8BitMixtape/ABK-20/.agents/skills/antigravity/SKILL.md

---
name: Antigravity Codebase Management
description: Comprehensive framework for generating 8-bit audio/visual synthesizers, managing the TinyAudioBoot WAV pipeline, and creating animated 5x4 matrix GIF & audio previews on ATtiny85 hardware.
---

# 8Bit-Vintage & Antigravity ATtiny85 Architecture & Workflows

This skill provides essential domain knowledge, architectural patterns, and standard workflows for creating, testing, and deploying audio synthesizers for the **8Bit Mixtape** and **ABK-20** (ATtiny85).

---

## 🛑 MANDATORY: Two-Phase Sound Development Workflow

When creating new sounds or synthesizers for the **ABK-20** or **8Bit Mixtape**, always strictly adhere to this two-phase process:

```
  PHASE 1: Local Code & Hardware Testing
  ┌────────────────────────────────────────────────────────┐
  │ 1. Write/edit C++ code in src/<app_id>.cpp             │
  │ 2. Activate in platformio.ini                          │
  │ 3. Run "pio run" (verify flash <= 6300 bytes)          │
  │ 4. User uploads & tests physically on hardware         │
  │ 5. Iterate on sound, controls & visuals                │
  │                                                        │
  │ ⛔ DO NOT create GIFs, MP3s, manuals, or apps.json!    │
  └────────────────────────────────────────────────────────┘
                            │
               User says: "Finalize this sound"
                            ▼
  PHASE 2: Web Assets & Publishing (ON USER COMMAND ONLY)
  ┌────────────────────────────────────────────────────────┐
  │ 1. Generate matrix GIF: scripts/gen_previews.py        │
  │ 2. Write manual: web/manuals/<APP_ID>_MANUAL.md        │
  │ 3. Generate preview MP3: scripts/gen_audio_previews.py │
  │ 4. Copy WAV: cp firmware.wav web/wav/<app_id>.wav      │
  │ 5. Register in web/apps.json & sync web/apps.js        │
  │ 6. Commit & push to GitHub                             │
  └────────────────────────────────────────────────────────┘
```

### Phase 1: Local Development & Hardware Testing (Iterative Loop)
1. **Develop Code Locally**:
   - Write or update `src/<app_id>.cpp`.
   - Use `my_delay()` (never Arduino's standard `delay()` which hangs when Timer0 is hijacked).
   - Ensure flash size $\le 6,300$ bytes (TinyAudioBoot ceiling).
   - Keep RAM $\le 80$ bytes (out of 512B).
2. **Compile Firmware**:
   - Select sketch in `platformio.ini` (`build_src_filter = -<*>, +<<app_id>.cpp>`).
   - Run compilation: `pio run`. PlatformIO compiles and generates `.pio/build/attiny85/firmware.hex` and `.pio/build/attiny85/firmware.wav`.
3. **Hardware Upload & Testing (User-Driven)**:
   - Instruct the user to upload: `pio run --target upload` (or play `.pio/build/attiny85/firmware.wav` into the audio jack).
   - The user tests the sound, potentiometers, buttons, and NeoPixel clarity on physical hardware.
   - Refine and iterate code based on user feedback.
4. **STRICT RULE DURING PHASE 1**:
   - **DO NOT** generate GIFs.
   - **DO NOT** generate MP3 audio previews.
   - **DO NOT** write manuals.
   - **DO NOT** modify `web/apps.json`, `web/apps.js`, or `web/index.html`.
   - Keep the workspace focused purely on getting the code and hardware sound perfect first!

### Phase 2: Web Assets & Finalization (ONLY ON EXPLICIT USER COMMAND)
Only when the user is completely satisfied with the sound and explicitly commands to publish/finalize:
1. **Create Preview GIF**:
   - Implement `<app_id>_frames()` in `scripts/gen_previews.py`.
   - Run: `python3 scripts/gen_previews.py <app_id>`.
2. **Write User Manual**:
   - Create `web/manuals/<APP_ID_UPPER>_MANUAL.md`.
3. **Generate Audio Preview MP3**:
   - Implement `synth_<app_id>()` in `scripts/gen_audio_previews.py`.
   - Run: `python3 -c "from scripts.gen_audio_previews import ...; write_wav_to_mp3(s, r, 'web/audio/<app_id>.mp3')"`.
4. **Publish Production WAV**:
   - Copy `.pio/build/attiny85/firmware.wav` to `web/wav/<app_id>.wav`.
5. **Update Web Catalog**:
   - Add entry to `web/apps.json` with final `flash_bytes` and `wav_bytes`.
   - Sync `web/apps.js` and verify `web/index.html`.
6. **Commit & Push**:
   - Git stage, commit, and push to GitHub.

---

## 1. Hardware Specifications & Pin Mapping

* **MCU**: Microchip ATtiny85 (8 KB Flash, 512 B SRAM, 512 B EEPROM)
* **Clock**: 16 MHz Internal PLL (required for WS2812B 800 kHz bit-bang timing)
* **Audio DAC**: 8-bit PWM carrier running at ~250 kHz generated by Timer1 in 64 MHz PLL mode on PB1 (`OC1A`)
* **Audio Sequencer/Sample Clock**: Timer0 COMPA interrupt running at 10 kHz (100 µs tick)
* **Visuals**: 20x WS2812B / SK6812 NeoPixels arranged in a 5×4 matrix on PB0
* **Inputs**:
  * PB4 (ADC2 / A2): Left Potentiometer (`POTI_LEFT`)
  * PB2 (ADC1 / A1): Right Potentiometer (`POTI_RIGHT`)
  * PB3 (ADC3 / A3): Resistor Ladder Pushbuttons (`BUTTON_PIN`)
  * PB5: Reset Pin (Power-On reset used by AudioBoot)

### Resistor Ladder Button Calibration (PB3 / A3)
```cpp
#define Vbutton_releaseLevel  490
#define Vbutton_left          460
#define Vbutton_right         395
#define Vbutton_both          320
```

> [!CAUTION]
> **Timer0 & Delay Rule**: When Timer0 is configured for a custom 10 kHz sample clock (`TCCR0A = 3; TCCR0B = 0x0A; OCR0A = 199;`), the Arduino core `delay()` and `micros()` will hang because `TOV0` (overflow) never triggers. Always use the tick-based delay routine:
> ```cpp
> void my_delay(uint16_t ms) {
>   uint16_t duration = ms * 10;
>   uint16_t start;
>   uint8_t sreg = SREG; cli(); start = ticks; SREG = sreg;
>   while (1) {
>     uint16_t current;
>     sreg = SREG; cli(); current = ticks; SREG = sreg;
>     if ((uint16_t)(current - start) >= duration) break;
>   }
> }
> ```

---

## 2. Animated Matrix GIF Previews (`scripts/gen_previews.py`)

*(Executed only in Phase 2 upon user command).*

### Matrix Geometry & Canvas
* **Matrix Size**: 5 columns wide $\times$ 4 rows high (20 LEDs total).
* **Cell Size**: Each virtual LED is rendered as a $30\text{ px} \times 24\text{ px}$ cell with a $1\text{ px}$ dark border (`(10, 10, 10)`), producing an overall GIF dimension of **$150\text{ px} \times 96\text{ px}$**.
* **Engine**: Python Pillow (`PIL.Image`).

### Adding a New GIF Preview
1. In `scripts/gen_previews.py`, define `<app_id>_frames()` returning `(frames_list, delay_ms)` (typically 30–60 frames @ 50 ms = 20 FPS).
2. Register: `RENDERERS["<app_id>"] = <app_id>_frames`.
3. Ensure app is registered in `web/apps.json`.
4. Run: `python3 scripts/gen_previews.py <app_id>`. Output: `web/gifs/<app_id>.gif`.

---

## 3. The Vintage "Analog Noise" Texture Technique

When designing visualizer frames for retro synthesizers (like *Léon Theremin*, *Bach Air*, or *Schaltkreiskontrolle*), you can intentionally harness Pillow's 8-bit palette quantizer to produce an authentic **vacuum-tube / cathode-ray glow & radio-static dithering**:

* **How it Works**:
  Instead of rendering only binary, flat on/off RGB blocks, incorporate continuous mathematical gradients:
  * Soft sinusoids: `int((math.sin(x * 0.8 + y * 0.9 + f * 0.2) * 0.5 + 0.5) * 35)`
  * Multi-stop phosphor persistence: trace = `(40, 255, 60)`, adjacent persistence halo = `(10, 80, 20)`
  * Candle flame / plasma flicker: `(f * 7) & 31`
* **Result**:
  When Pillow quantizes these continuous RGB values into an indexed 256-color GIF palette, **Floyd-Steinberg error-diffusion dithering** scatters intermediate shades across adjacent matrix cells. This generates a subtle, living analogue "grain" reminiscent of 1920s electron tubes and CRT scopes!

---

## 4. Audio Preview Generation (`scripts/gen_audio_previews.py`)

*(Executed only in Phase 2 upon user command).*

1. **Define Synthesis Routine** in `scripts/gen_audio_previews.py`:
   ```python
   def synth_my_app():
       sample_rate = 10000
       duration_sec = 6.0
       total_samples = int(sample_rate * duration_sec)
       samples = bytearray(total_samples)
       # Emulate the C++ DDS oscillator algorithm in Python...
       return samples, sample_rate
   ```
2. **Add to `synths` List** in `main()`.
3. **Generate MP3 via FFmpeg**:
   ```bash
   python3 -c "from scripts.gen_audio_previews import synth_my_app, write_wav_to_mp3, AUDIO_DIR; s, r = synth_my_app(); write_wav_to_mp3(s, r, AUDIO_DIR / 'my_app.mp3')"
   ```

---

## 5. AudioBoot WAV Pipeline & Flash Budget

* **TinyAudioBoot Constraint**: TinyAudioBoot lives at the top of flash (`0x1A00`–`0x2000`, i.e. byte 6,656+).
* **Hard Flash Ceiling**: Application firmware **MUST remain strictly under 6,300 bytes** (ideally $\le 5,800$ bytes). Exceeding 6,400 bytes causes bootloader corruption or flashing failure.
* **Compilation**:
  ```bash
  pio run
  # Output: .pio/build/attiny85/firmware.hex and .pio/build/attiny85/firmware.wav
  ```
* **Publishing WAV (Phase 2 Only)**:
  ```bash
  cp .pio/build/attiny85/firmware.wav web/wav/<app_id>.wav
  ```
* **Syncing Metadata (Phase 2 Only)**:
  Update `flash_bytes` and `wav_bytes` in `web/apps.json`, then regenerate `web/apps.js`:
  ```bash
  python3 -c "import json; apps = json.load(open('web/apps.json')); open('web/apps.js', 'w').write('// Generated by scripts/build_wavs.py from apps.json - do not edit.\nwindow.APPS = ' + json.dumps(apps, indent=2) + ';\n')"
  ```
