8BitMixtape/ABK-20/docs/ABK-20_schematic_5x4.png

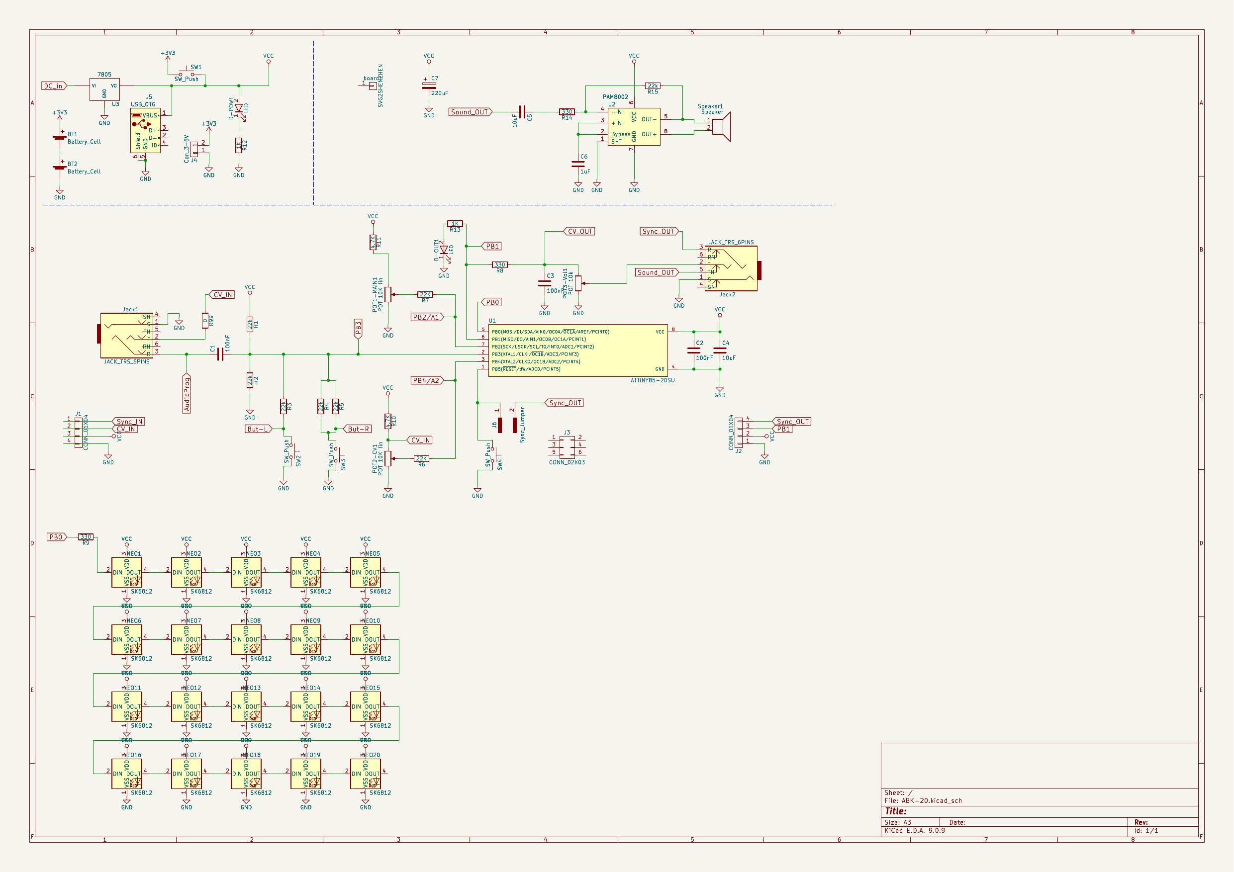
docs/ABK-20_schematic_5x4.png
