8BitMixtape/ABK-20/docs/gifs/acid_AKB-20.gif

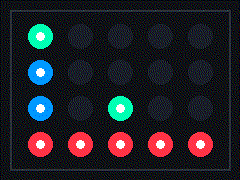
docs/gifs/acid_AKB-20.gif
