8BitMixtape/ABK-20/docs/img/ABK-20_case_3dprint_plate.png

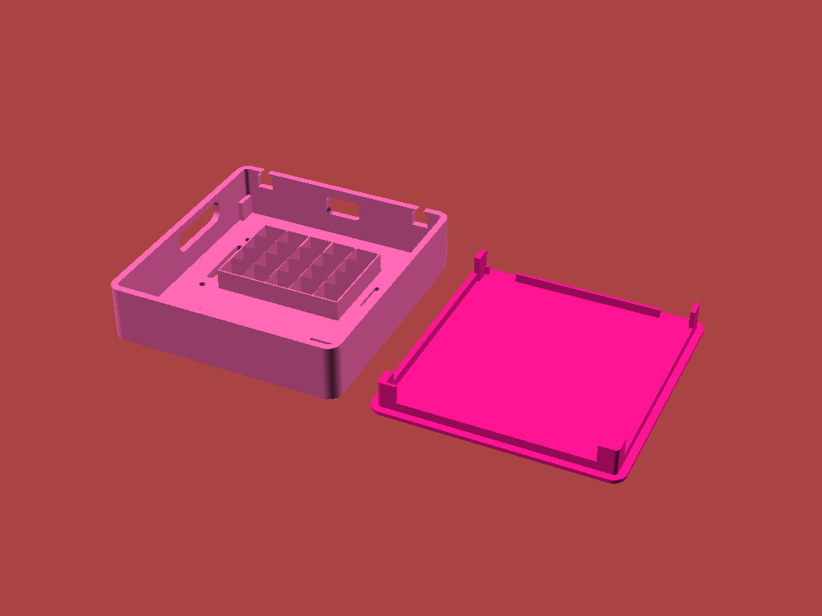
docs/img/ABK-20_case_3dprint_plate.png
