8BitMixtape/ABK-20/docs/img/ABK-20_diy_drill_handout.png

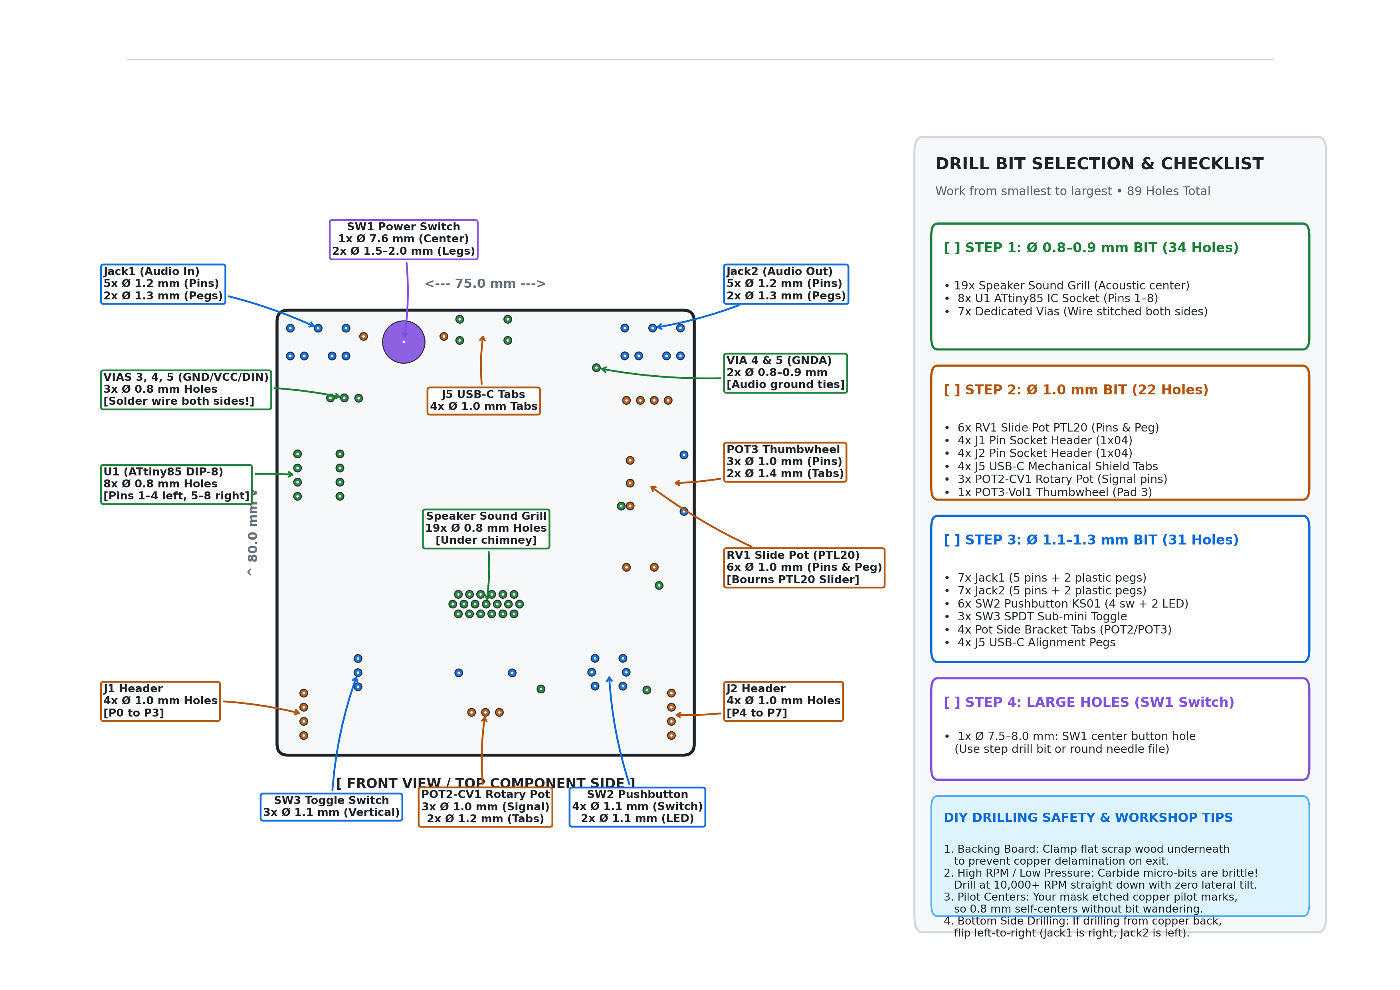
docs/img/ABK-20_diy_drill_handout.png
