8BitMixtape/ABK-20/docs/img/battery_holder_preview.png

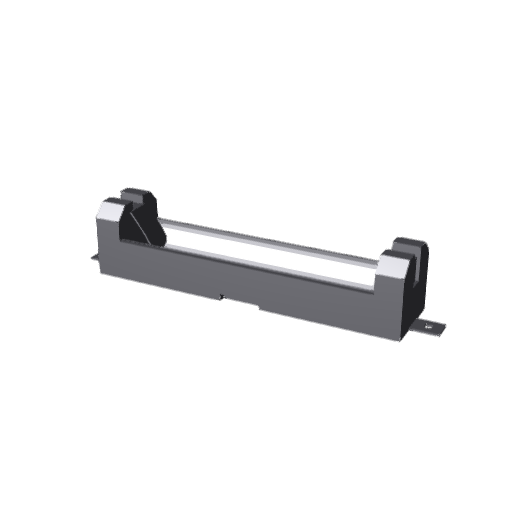
docs/img/battery_holder_preview.png
