8BitMixtape/ABK-20/docs/img/done_bottom.png

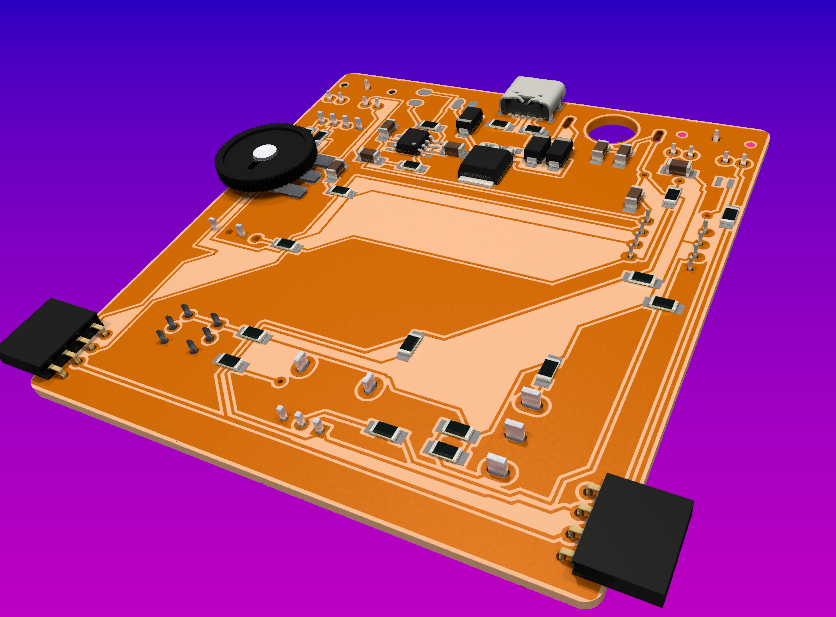
docs/img/done_bottom.png
