8BitMixtape/ABK-20/docs/img/done_top.png

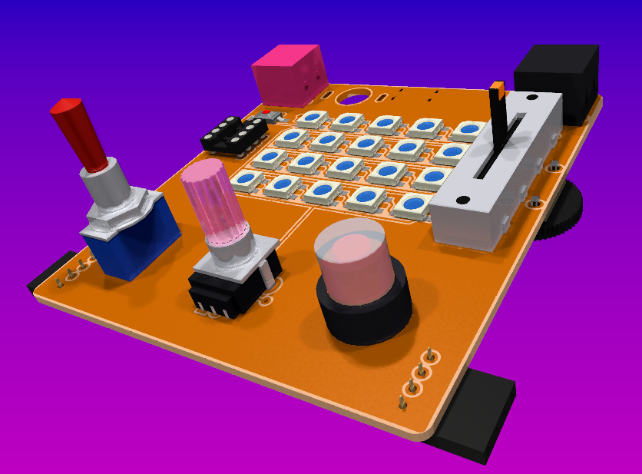
docs/img/done_top.png
