8BitMixtape/ABK-20/docs/img/pot_slide_led.png

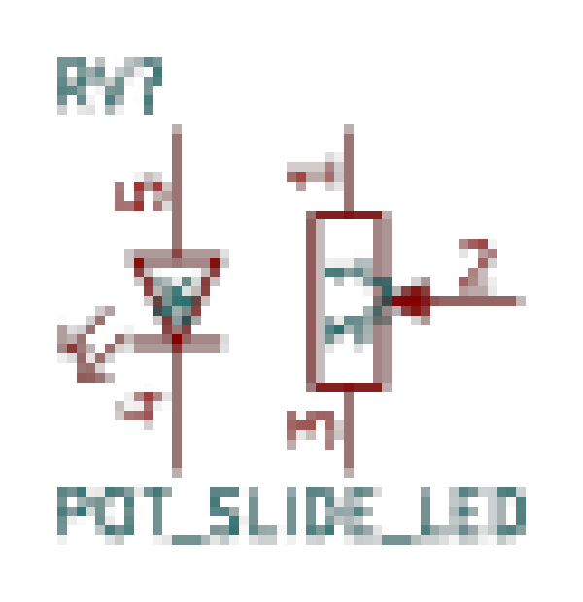
docs/img/pot_slide_led.png
