8BitMixtape/ABK-20/docs/img/speaker_loch_options.png

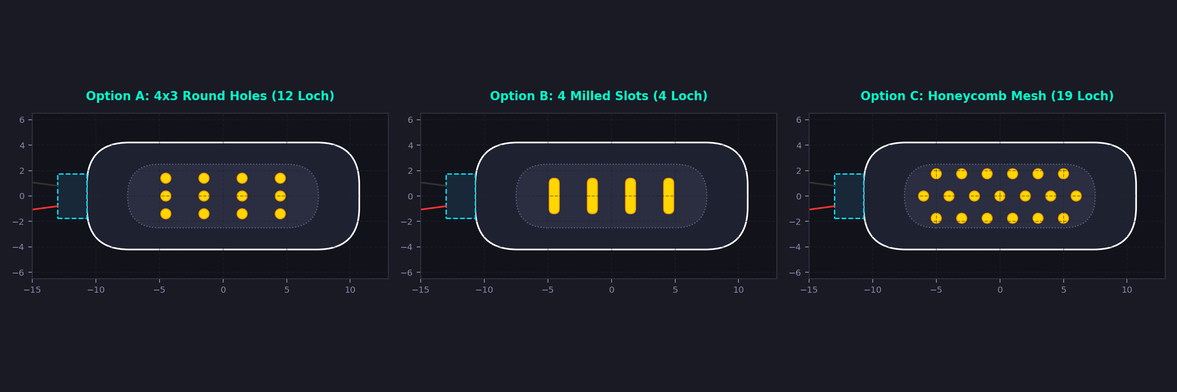
docs/img/speaker_loch_options.png
