8BitMixtape/ABK-20/docs/reference_schematic_clean.png

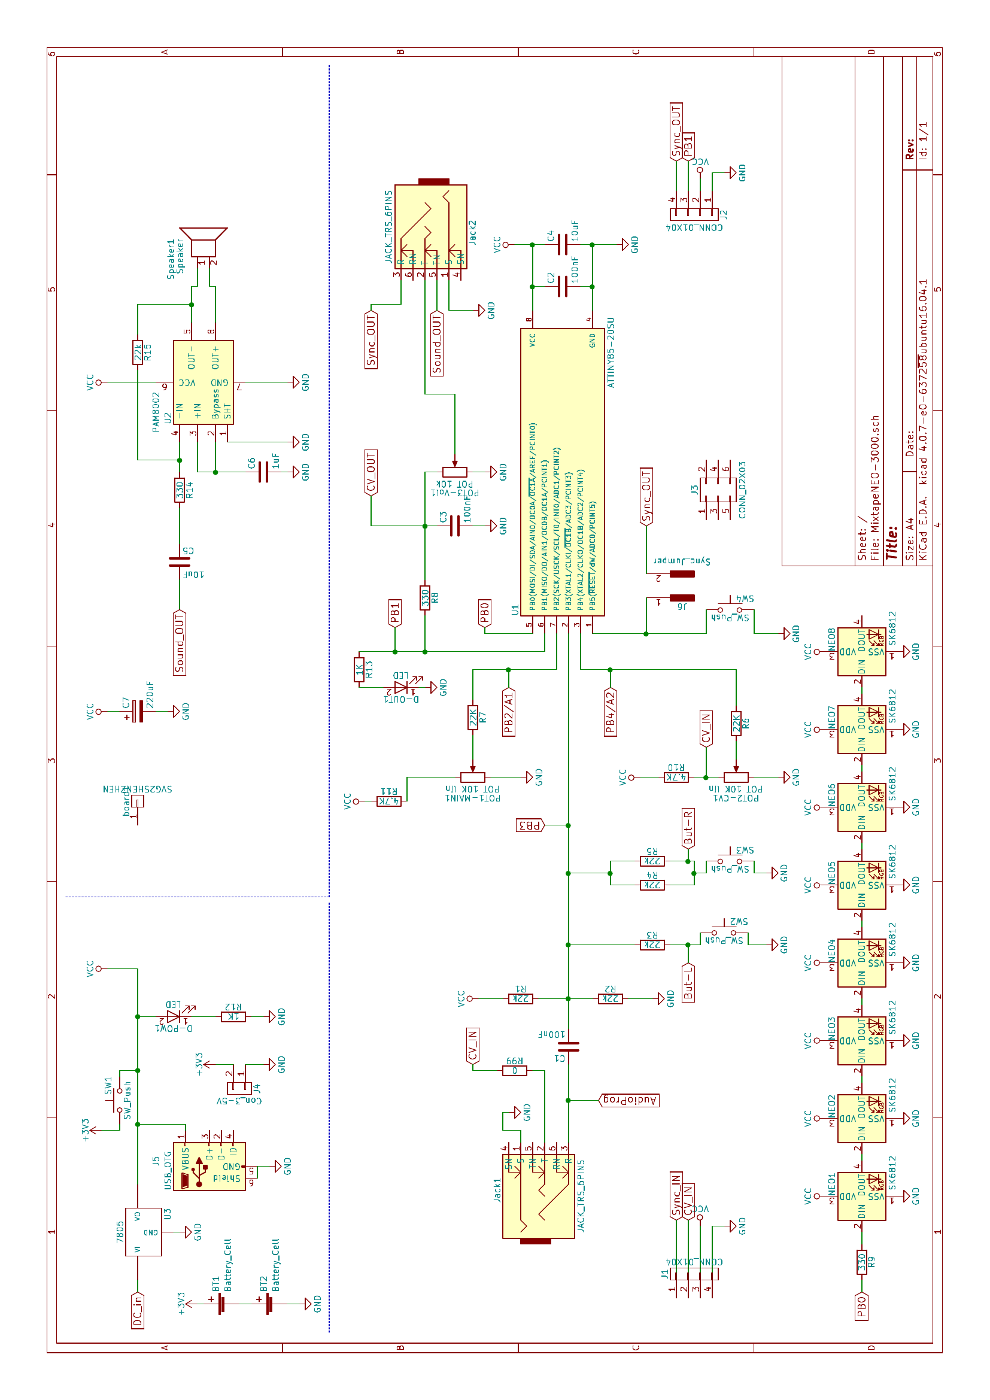
docs/reference_schematic_clean.png
