8BitMixtape/ABK-20/production/ABK20-case/img/BlinkeShit-Chistli.png

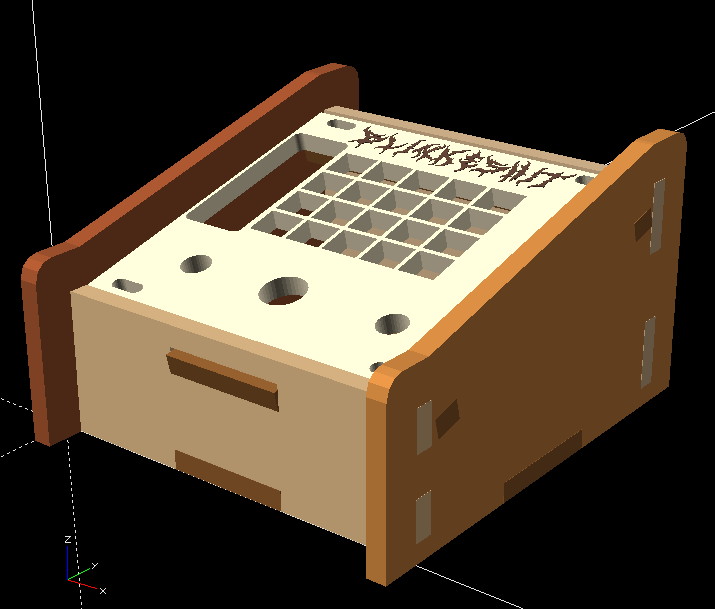
production/ABK20-case/img/BlinkeShit-Chistli.png
