8BitMixtape/ABK-20/production/ABK20-case/img/case_3dprint_underside.png

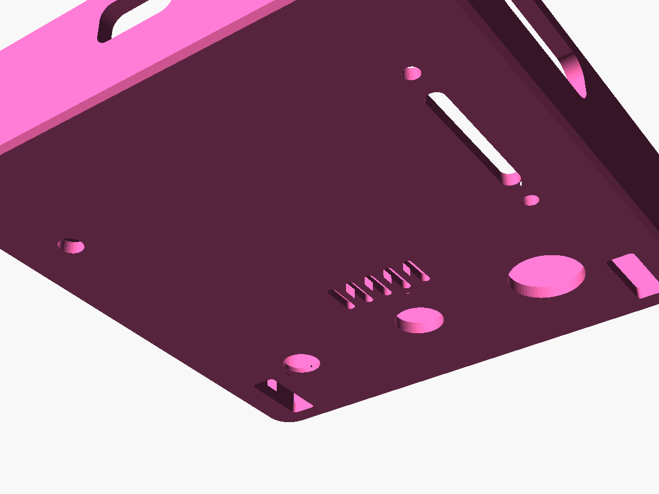
production/ABK20-case/img/case_3dprint_underside.png
