8BitMixtape/ABK-20/production/ABK20-case/img/cup_ported_labyrinth.png

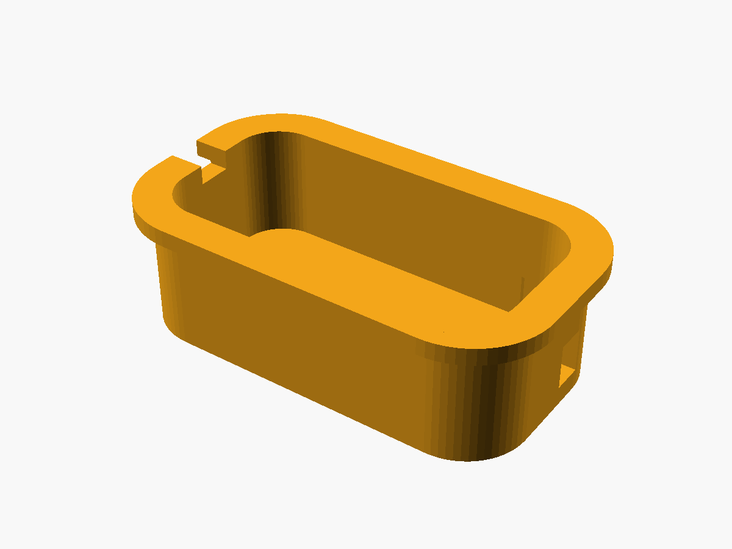
production/ABK20-case/img/cup_ported_labyrinth.png
