8BitMixtape/ABK-20/production/ABK20-case/img/Delay_Oli.png

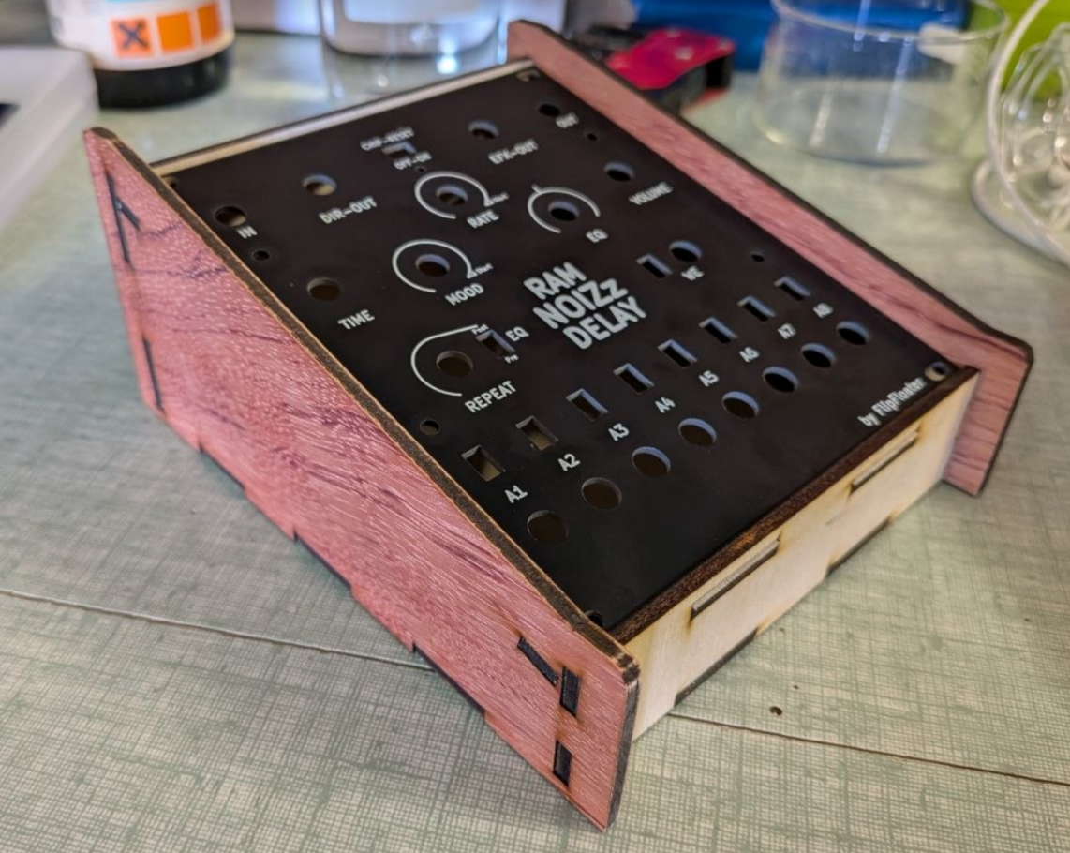
production/ABK20-case/img/Delay_Oli.png
