8BitMixtape/ABK-20/production/ABK20-case/img/frontplate_braun_dots.png

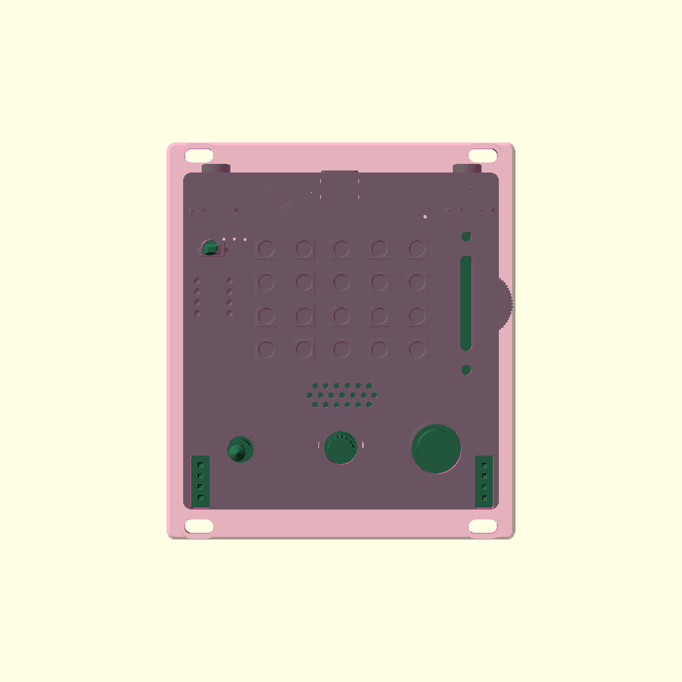
production/ABK20-case/img/frontplate_braun_dots.png
