8BitMixtape/ABK-20/production/ABK20-case/img/frontplate_centered_underside.png

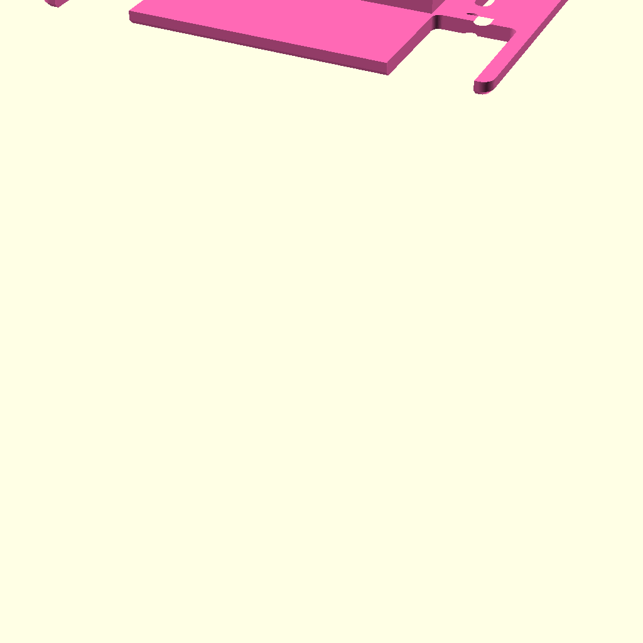
production/ABK20-case/img/frontplate_centered_underside.png
