8BitMixtape/ABK-20/production/ABK20-case/img/Screenshot_2D-layout.png

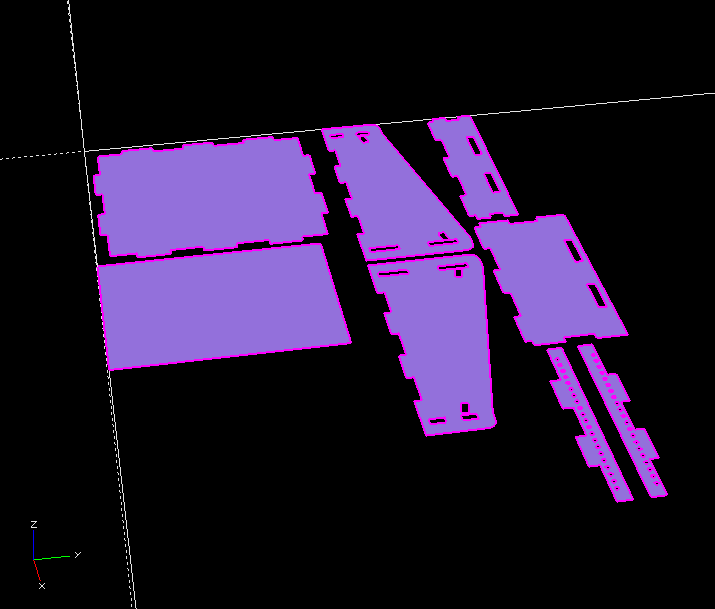
production/ABK20-case/img/Screenshot_2D-layout.png
