8BitMixtape/ABK-20/production/ABK20-case/img/Screenshot_openScad.png

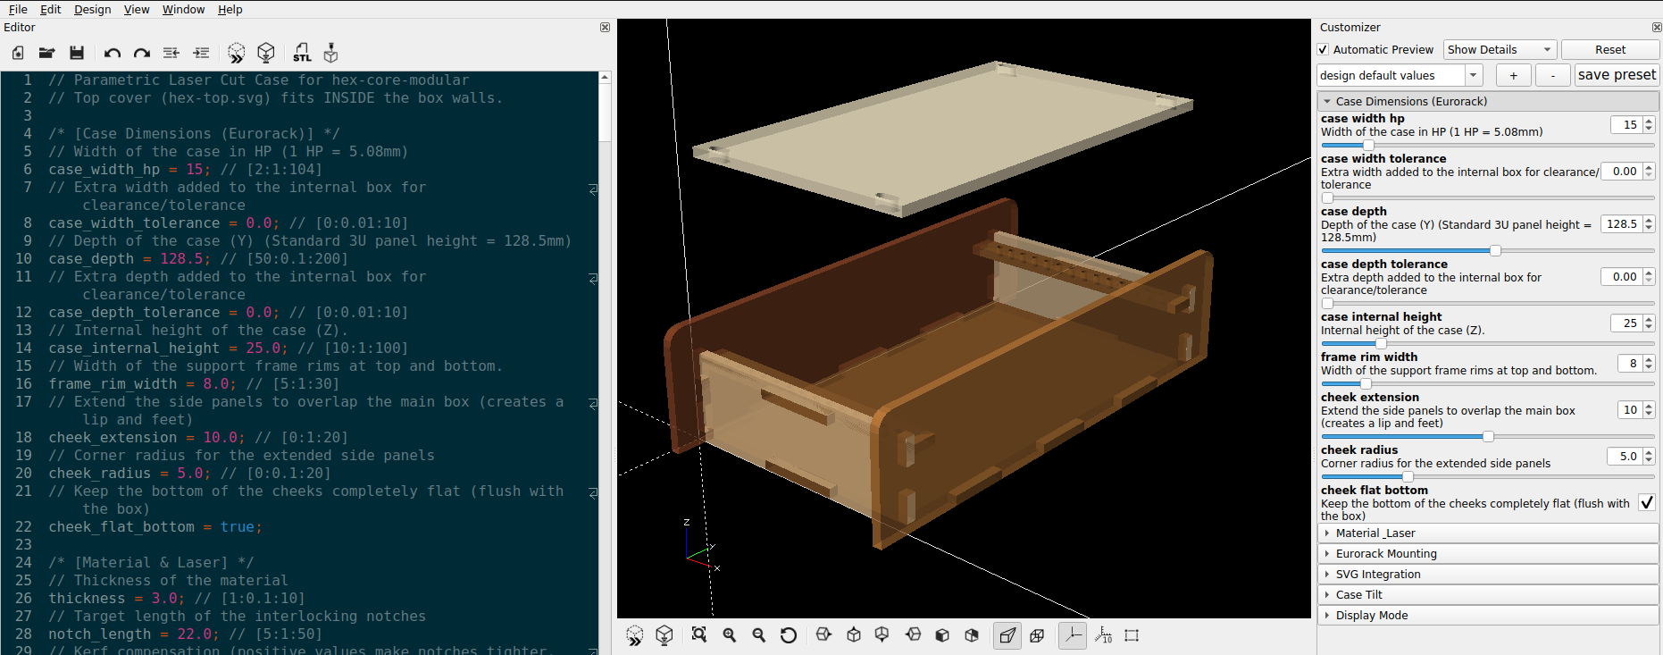
production/ABK20-case/img/Screenshot_openScad.png
