8BitMixtape/ABK-20/hardware/3d_models/USB_C_Receptacle.stl

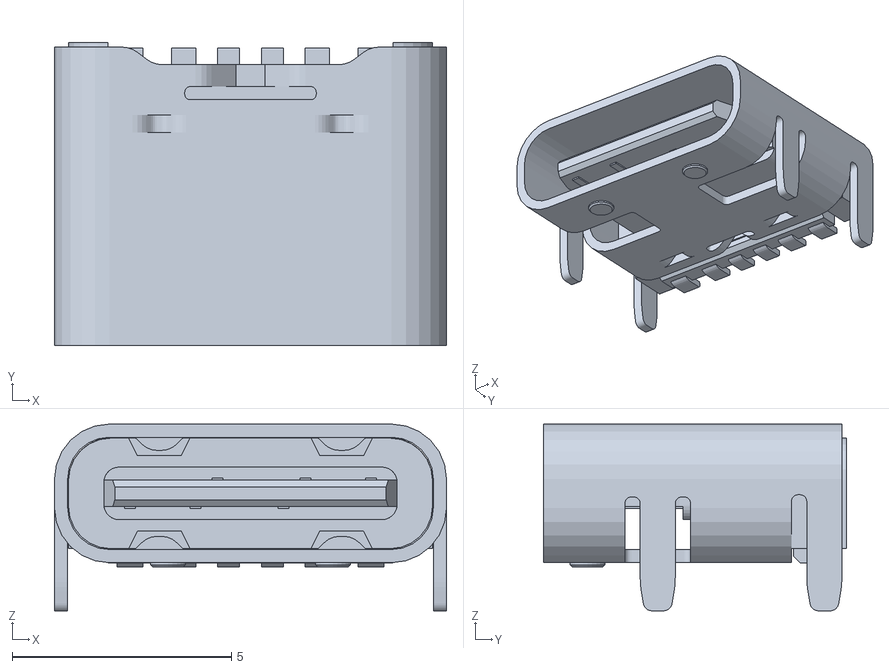
[picture p42: CAD file, 2026-10-31]
hardware/3d_models/USB_C_Receptacle.stl
8.94 x 6.90 x 4.26
