8BitMixtape/ABK-20/production/ABK20-case/ABK-20_pcb.stl

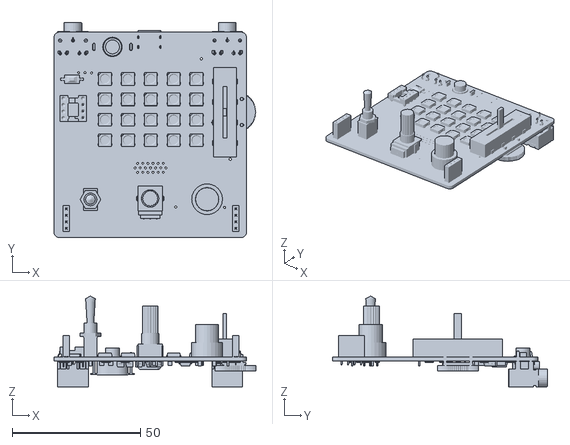
[picture p43: CAD file, 2026-11-02]
production/ABK20-case/ABK-20_pcb.stl
78.7 x 83.8 x 35.4
