8BitMixtape/ABK-20/production/stenchill/stencil_front.3mf

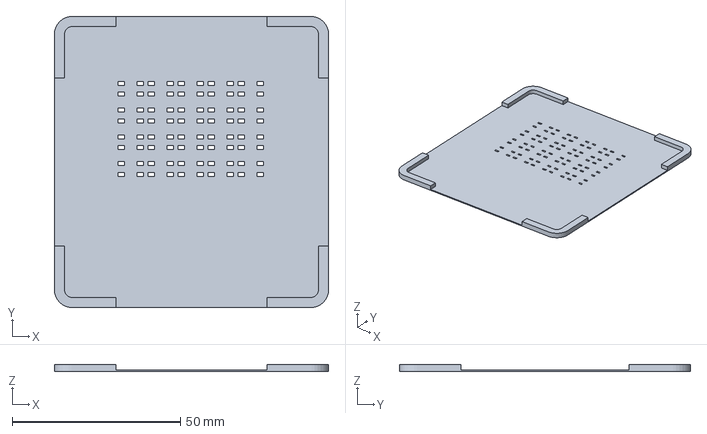
[picture p44: CAD file, 2026-11-02]
production/stenchill/stencil_front.3mf
81.6 x 86.6 x 2.00 mm
