8BitMixtape/ABK-20/hardware/3d_models/AudioJack_3.5mm_PJ-317_body.stl

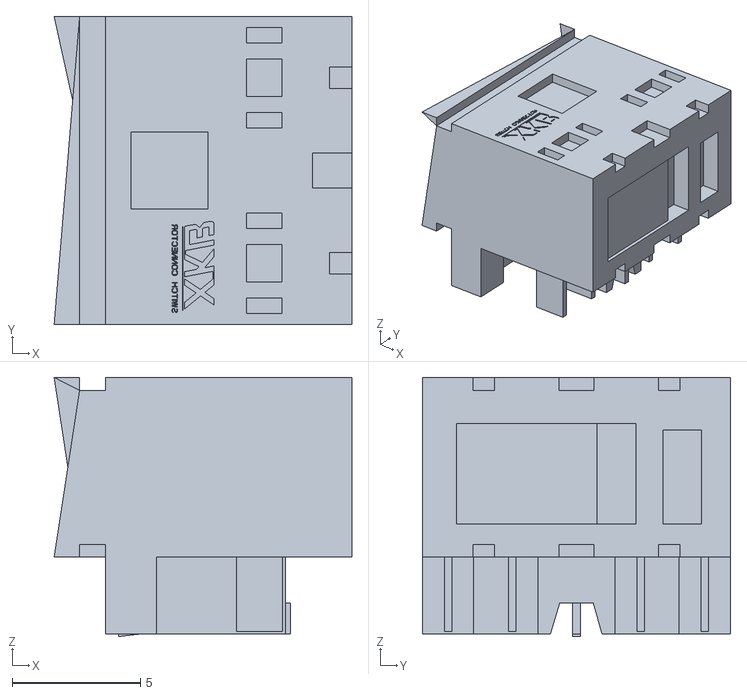
[picture p45: CAD file, 2026-10-31]
hardware/3d_models/AudioJack_3.5mm_PJ-317_body.stl
11.6 x 12.0 x 10.1
