8BitMixtape/ABK-20/production/ABK20-case/ABK-20_frontplate_3dprint.stl

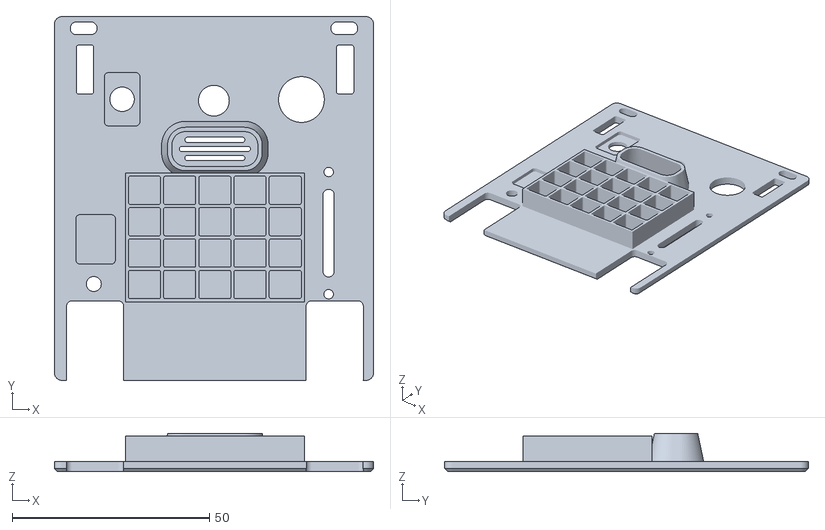
[picture p46: CAD file, 2026-10-31]
production/ABK20-case/ABK-20_frontplate_3dprint.stl
81.0 x 92.3 x 9.65
