8BitMixtape/ABK-20/hardware/3d_models/AudioJack_3.5mm_PJ-317_metal.stl

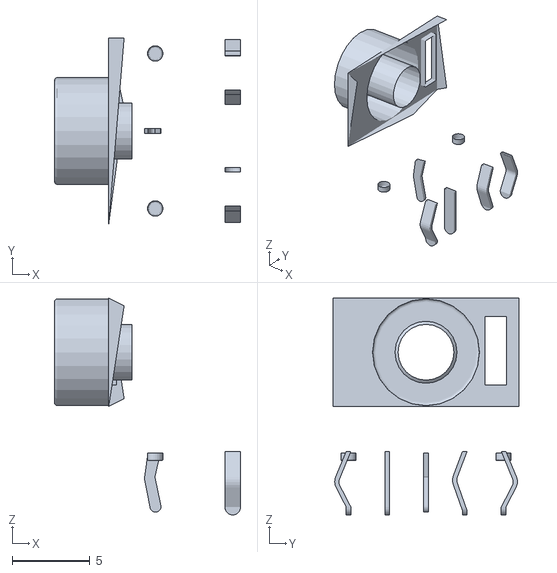
[picture p47: CAD file, 2026-10-31]
hardware/3d_models/AudioJack_3.5mm_PJ-317_metal.stl
12.0 x 12.0 x 14.0
