8BitMixtape/ABK-20/production/ABK20-case/ABK-20_accoustic_kit.3mf

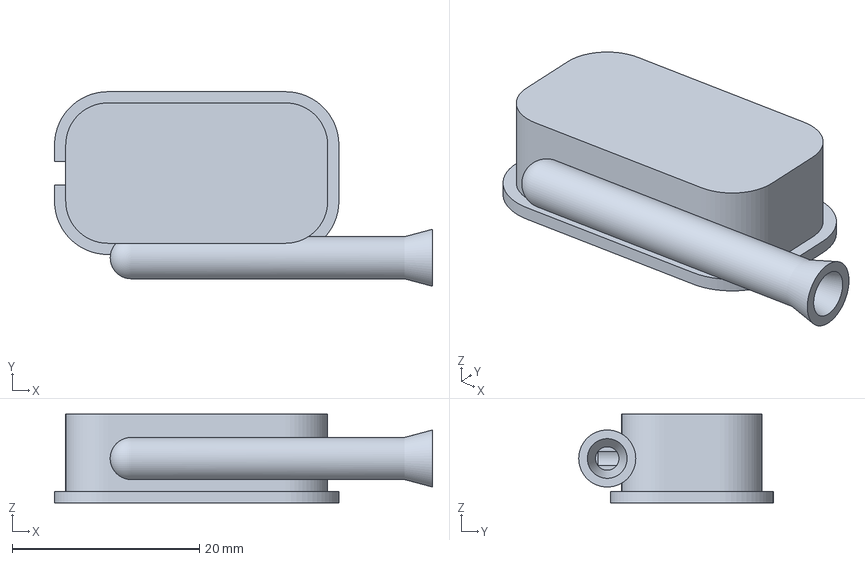
[picture p48: CAD file, 2026-10-31]
production/ABK20-case/ABK-20_accoustic_kit.3mf
40.4 x 20.8 x 9.50 mm
