8BitMixtape/ABK-20/hardware/3d_models/ALPHA-RD901F-40.step

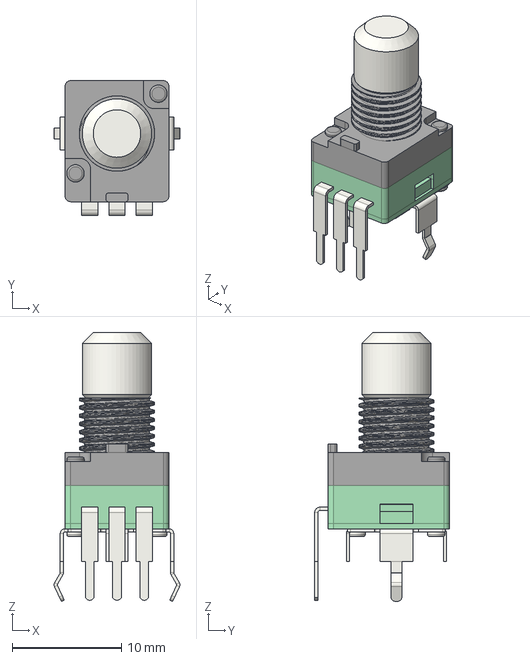
[picture p49: CAD file, 2026-10-17]
hardware/3d_models/ALPHA-RD901F-40.step
11.5 x 12.4 x 24.6 mm
