8BitMixtape/ABK-20/production/ABK20-case/ABK-20_case_3dprint.3mf

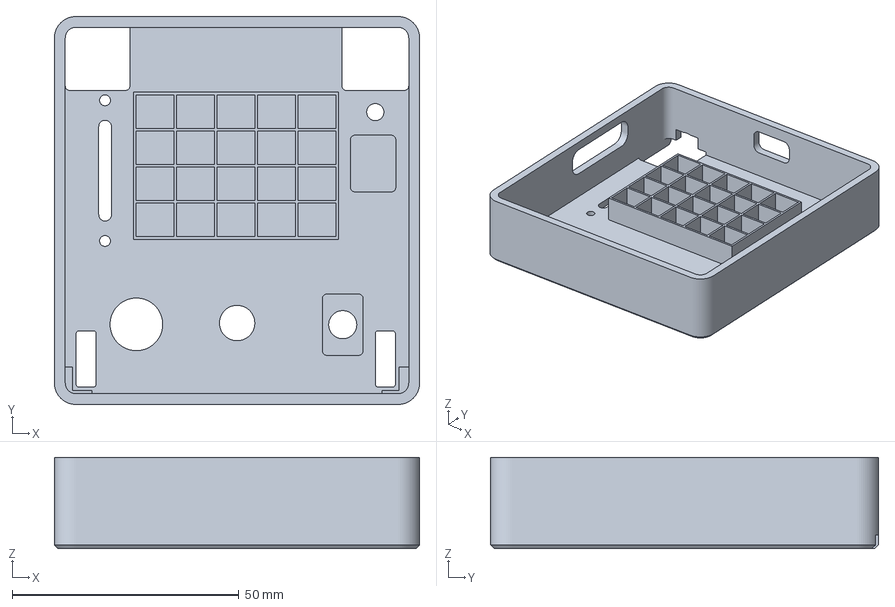
[picture p50: CAD file, 2026-10-31]
production/ABK20-case/ABK-20_case_3dprint.3mf
80.5 x 85.5 x 20.1 mm
