8BitMixtape/ABK-20/hardware/3d_models/SW_SPST_Omron_B3FS-100xP.step

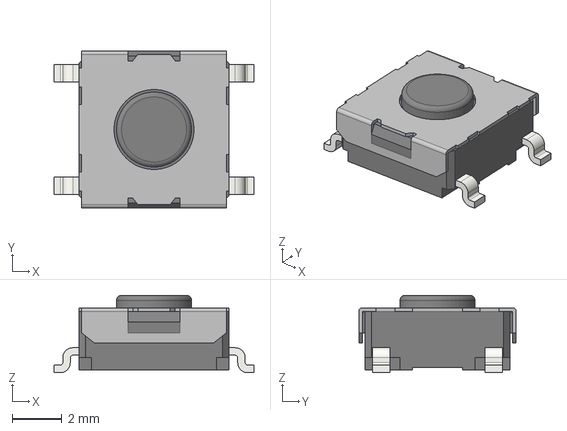
[picture p51: CAD file, 2026-10-17]
hardware/3d_models/SW_SPST_Omron_B3FS-100xP.step
8.00 x 6.30 x 3.10 mm
