8BitMixtape/ABK-20/production/ABK20-case/ABK-20.step

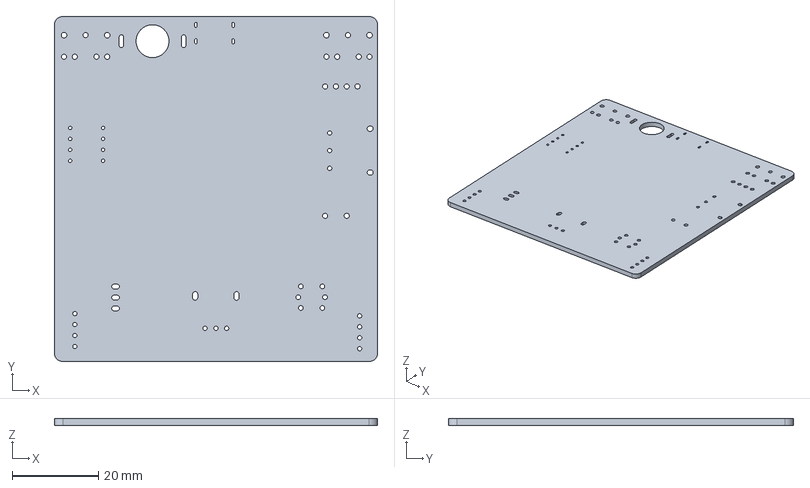
[picture p52: CAD file, 2026-10-31]
production/ABK20-case/ABK-20.step
75.0 x 80.0 x 1.51 mm
LED_WS2812B_PLCC4_5.0x5.0mm_P3.2mm x 20
DIP-8_W7.62mm_Socket
Potentiometer_Bourns_PTL20_Single_Slide_LED
SW_Flashlight_12x8mm
SW_Toggle_SPDT_SubMini_RedCap
LED_1206_3216Metric
Potentiometer_RV09_Vertical_ClearPinkShaft
SW_SPST_FSMSM
SW_Push_Highly_KS01-BL-13
R_1206_3216Metric x 20
C_1206_3216Metric x 9
PinSocket_1x04_P2.54mm_Horizontal x 2
D_SMA x 3
Potentiometer_Thumbwheel_16mm_B103
AudioJack_3.5mm_PJ-317_Black
SOIC-8_3.9x4.9mm_P1.27mm
AudioJack_3.5mm_PJ-317_Pink
TO-252-3_TabPin2
USB_C_Receptacle_GCT_USB4125-xx-x_6P_TopMnt_Horizontal
ABK-20_PCB
