8BitMixtape/ABK-20/production/ABK20-case/ABK-20_case_3dprint_proto.stl

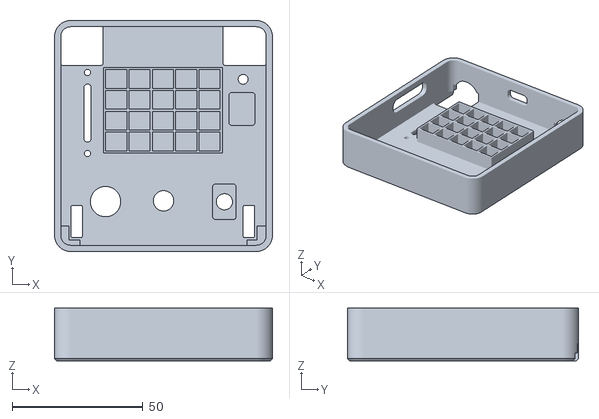
[picture p53: CAD file, 2026-10-31]
production/ABK20-case/ABK-20_case_3dprint_proto.stl
83.4 x 88.4 x 20.1
