8BitMixtape/ABK-20/production/ABK20-case/AudioJack_3.5mm_PJ-317.stl

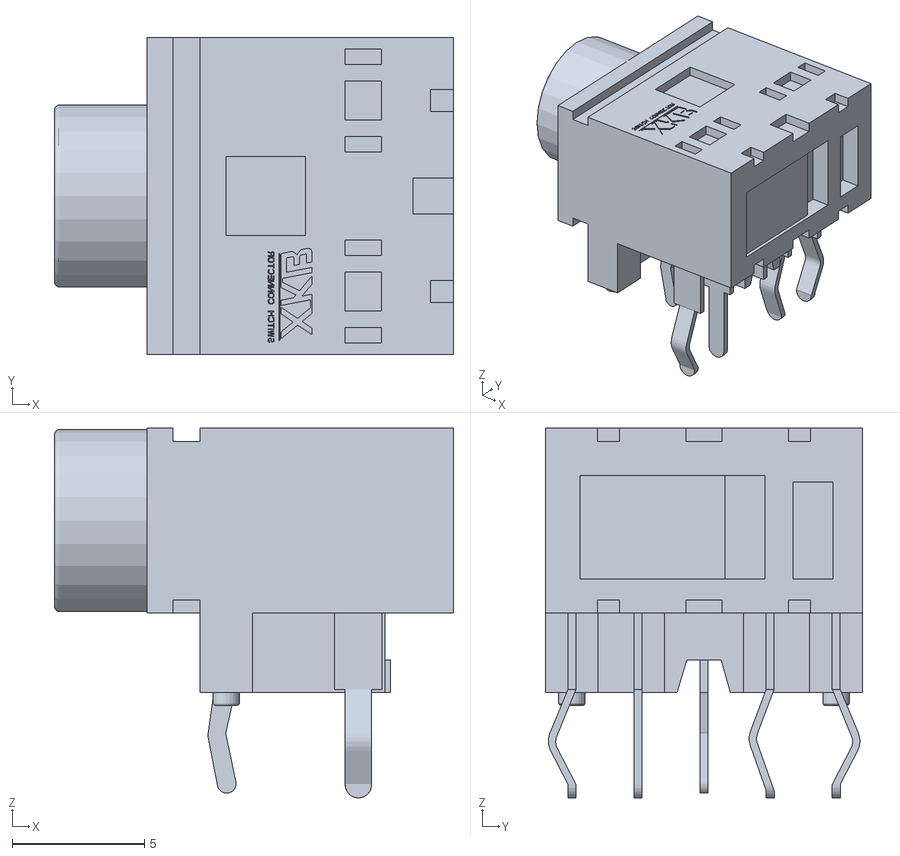
[picture p54: CAD file, 2026-10-31]
production/ABK20-case/AudioJack_3.5mm_PJ-317.stl
15.1 x 12.0 x 14.0
