8BitMixtape/ABK-20/(list of files, cad)

Other CAD files:
production/ABK20-case/test_grill_showcase.scad
production/ABK20-case/ABK-20_case_3dprint.stl
production/stenchill/stencil_front.stl
