8BitMixtape/ABK-20/docs/img/ABK-20_diy_ground_and_vias_guide.png

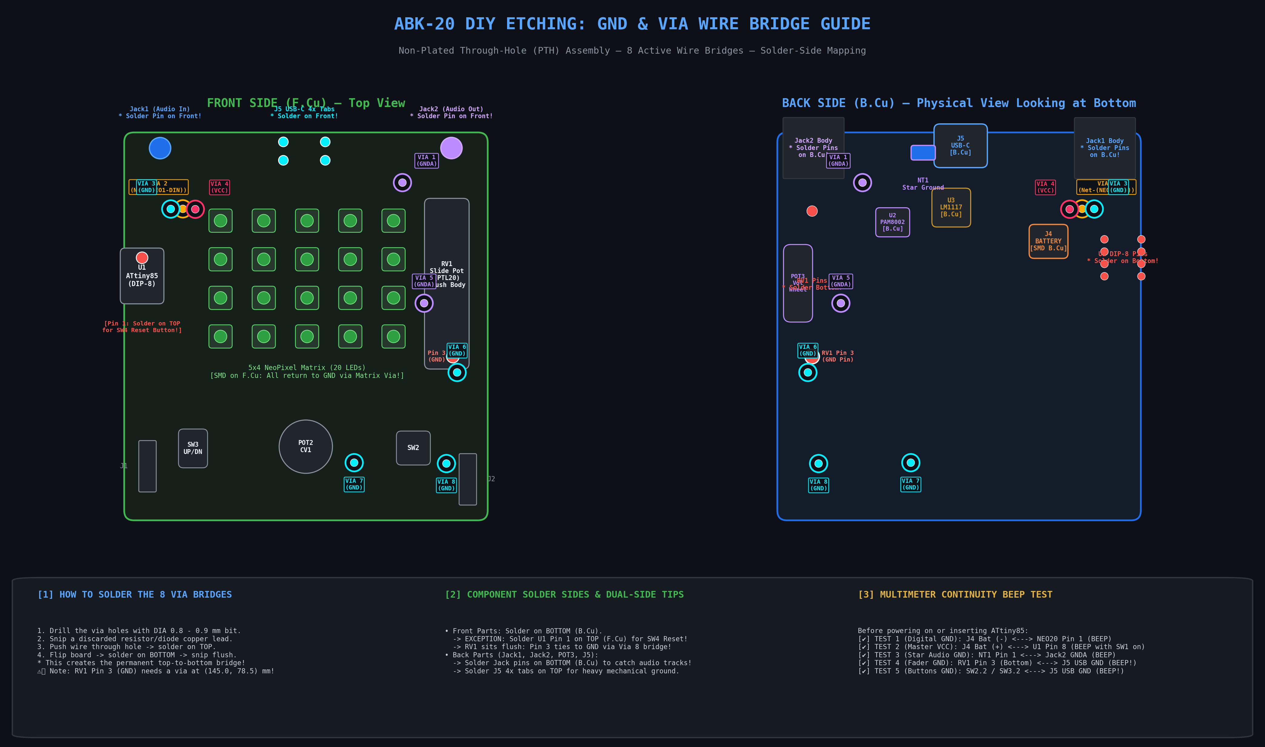
docs/img/ABK-20_diy_ground_and_vias_guide.png
