8BitMixtape/ABK-20/docs/gifs/interface_test_AKB20.gif

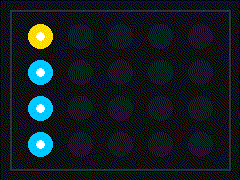
docs/gifs/interface_test_AKB20.gif
