8BitMixtape/ABK-20/web/gifs/test_bicolor_led.gif

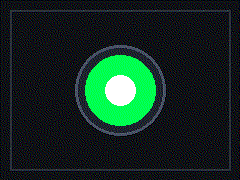
web/gifs/test_bicolor_led.gif
