8BitMixtape/ABK-20/docs/ABK-20_schematic.pdf

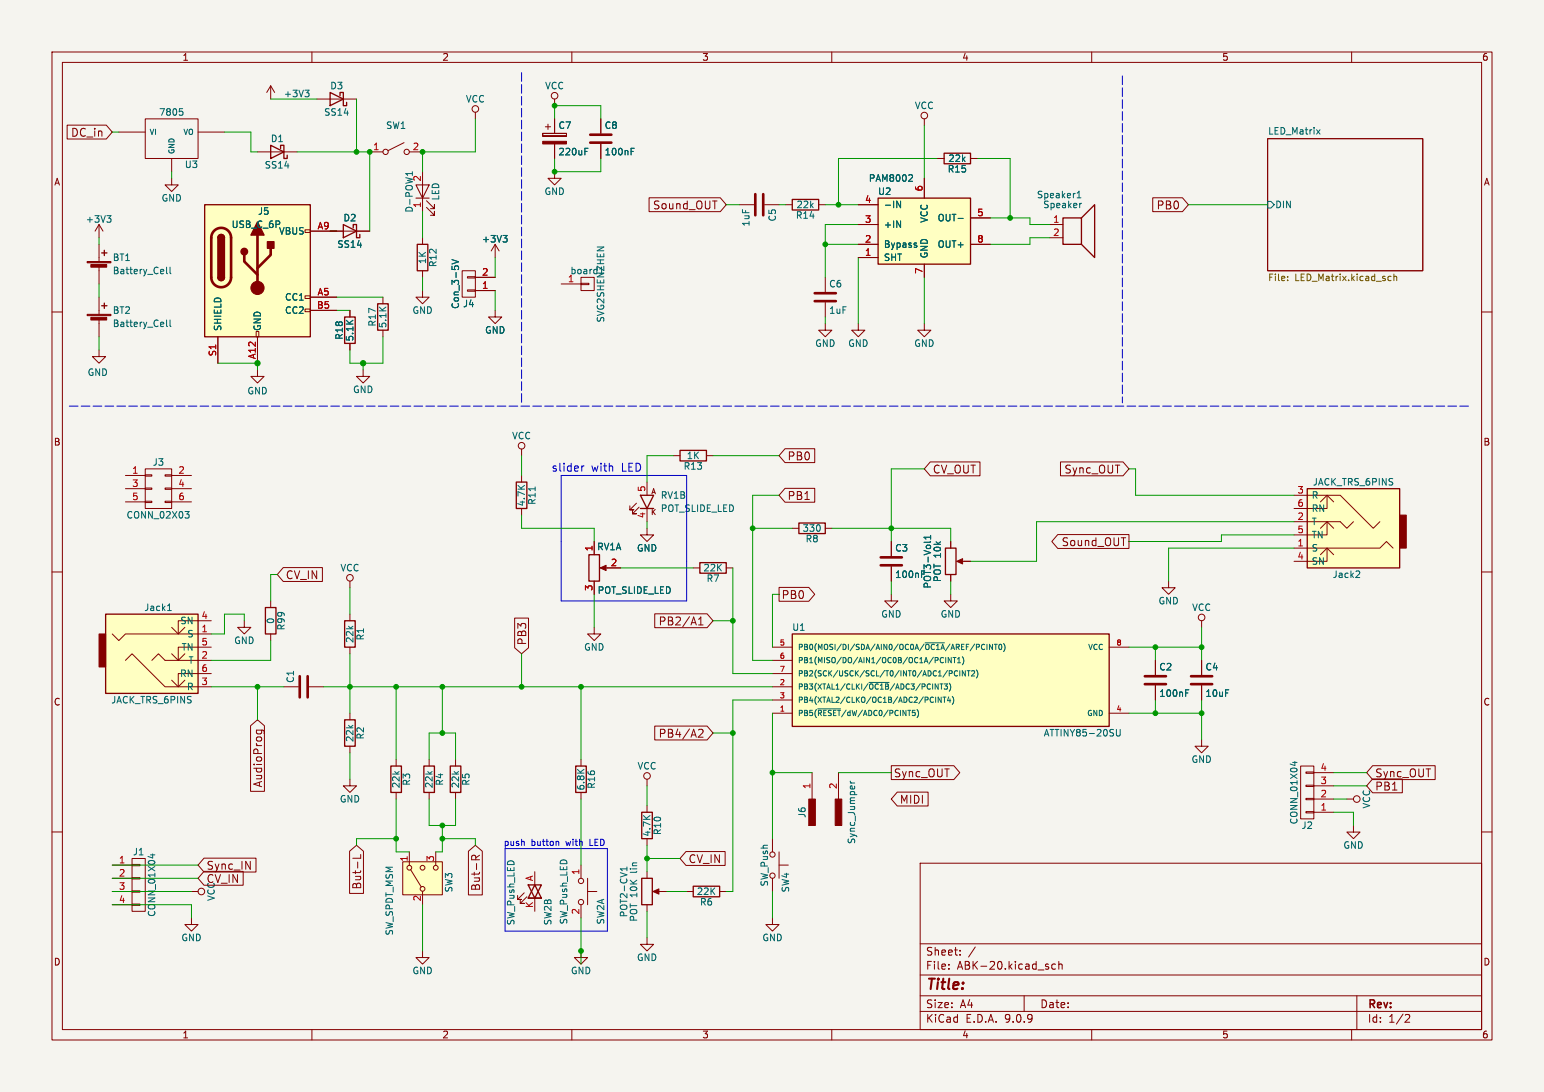
[picture p58: page 1]

7 OUT- 5 OUT+ 8 U2 PAM8002 GND GND

push button with LED

Id: 1/2 Title: File: ABK-20.kicad_sch Sheet: /

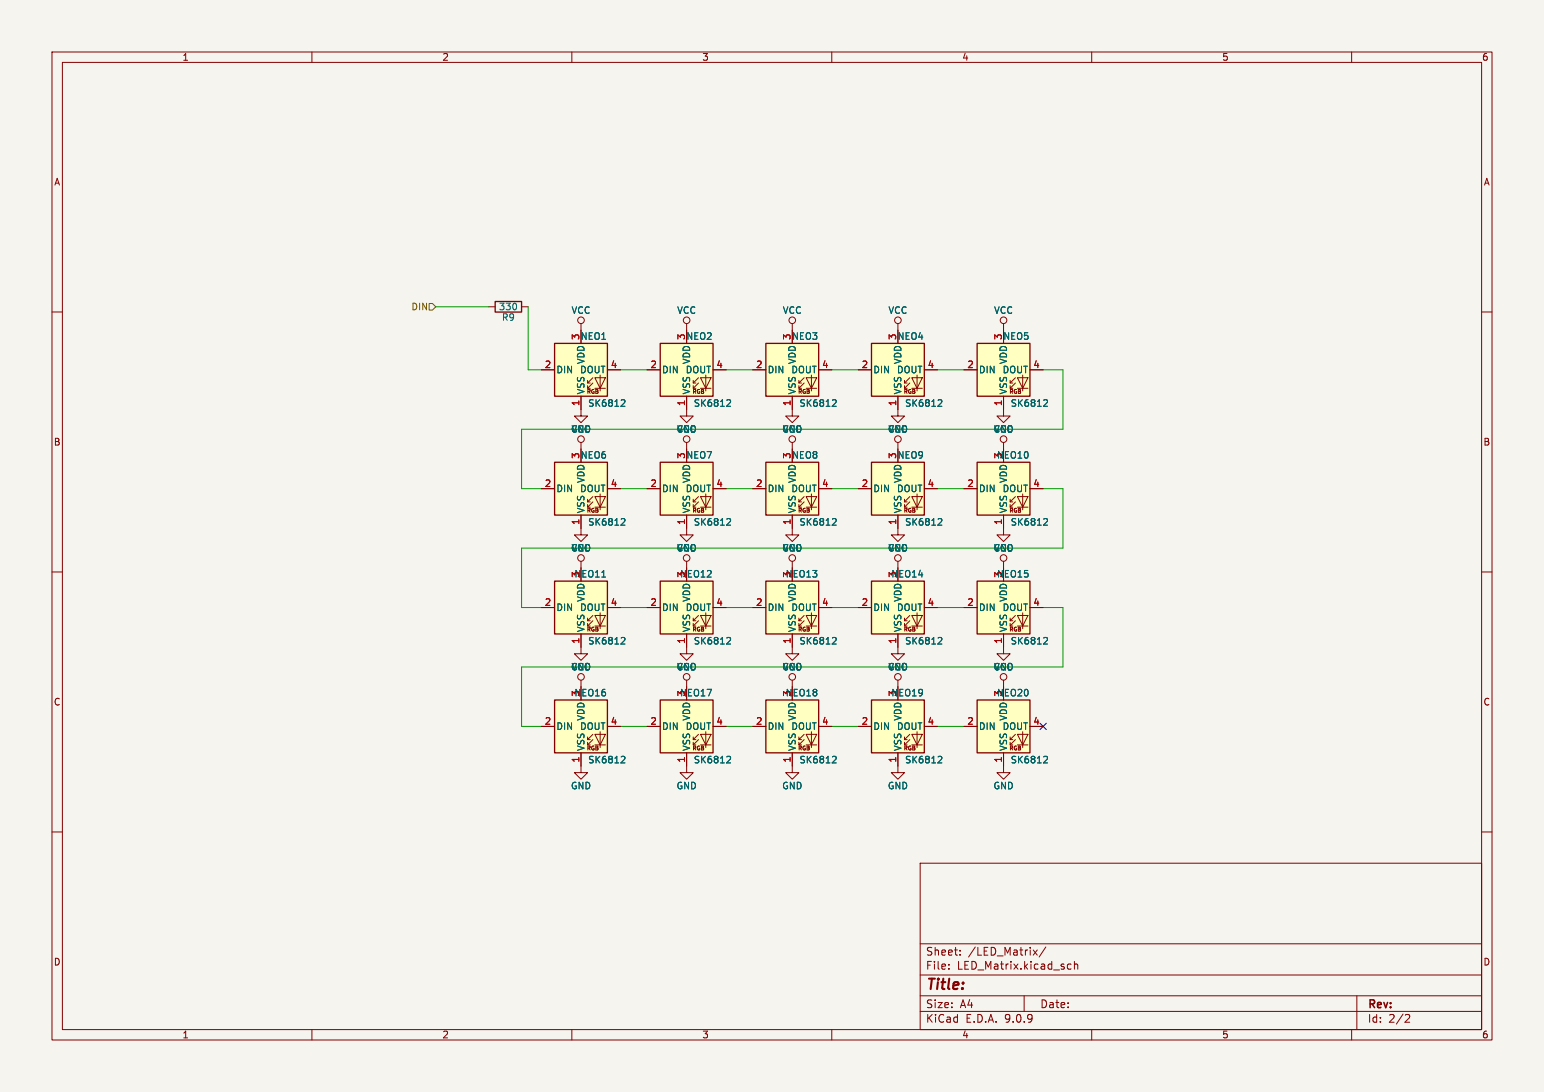
[picture p59: page 2]

Id: 2/2 Title: File: LED_Matrix.kicad_sch Sheet: /LED_Matrix/ GND GND
