8BitMixtape/ABK-20/docs/ABK-20_schematic_5x4.pdf

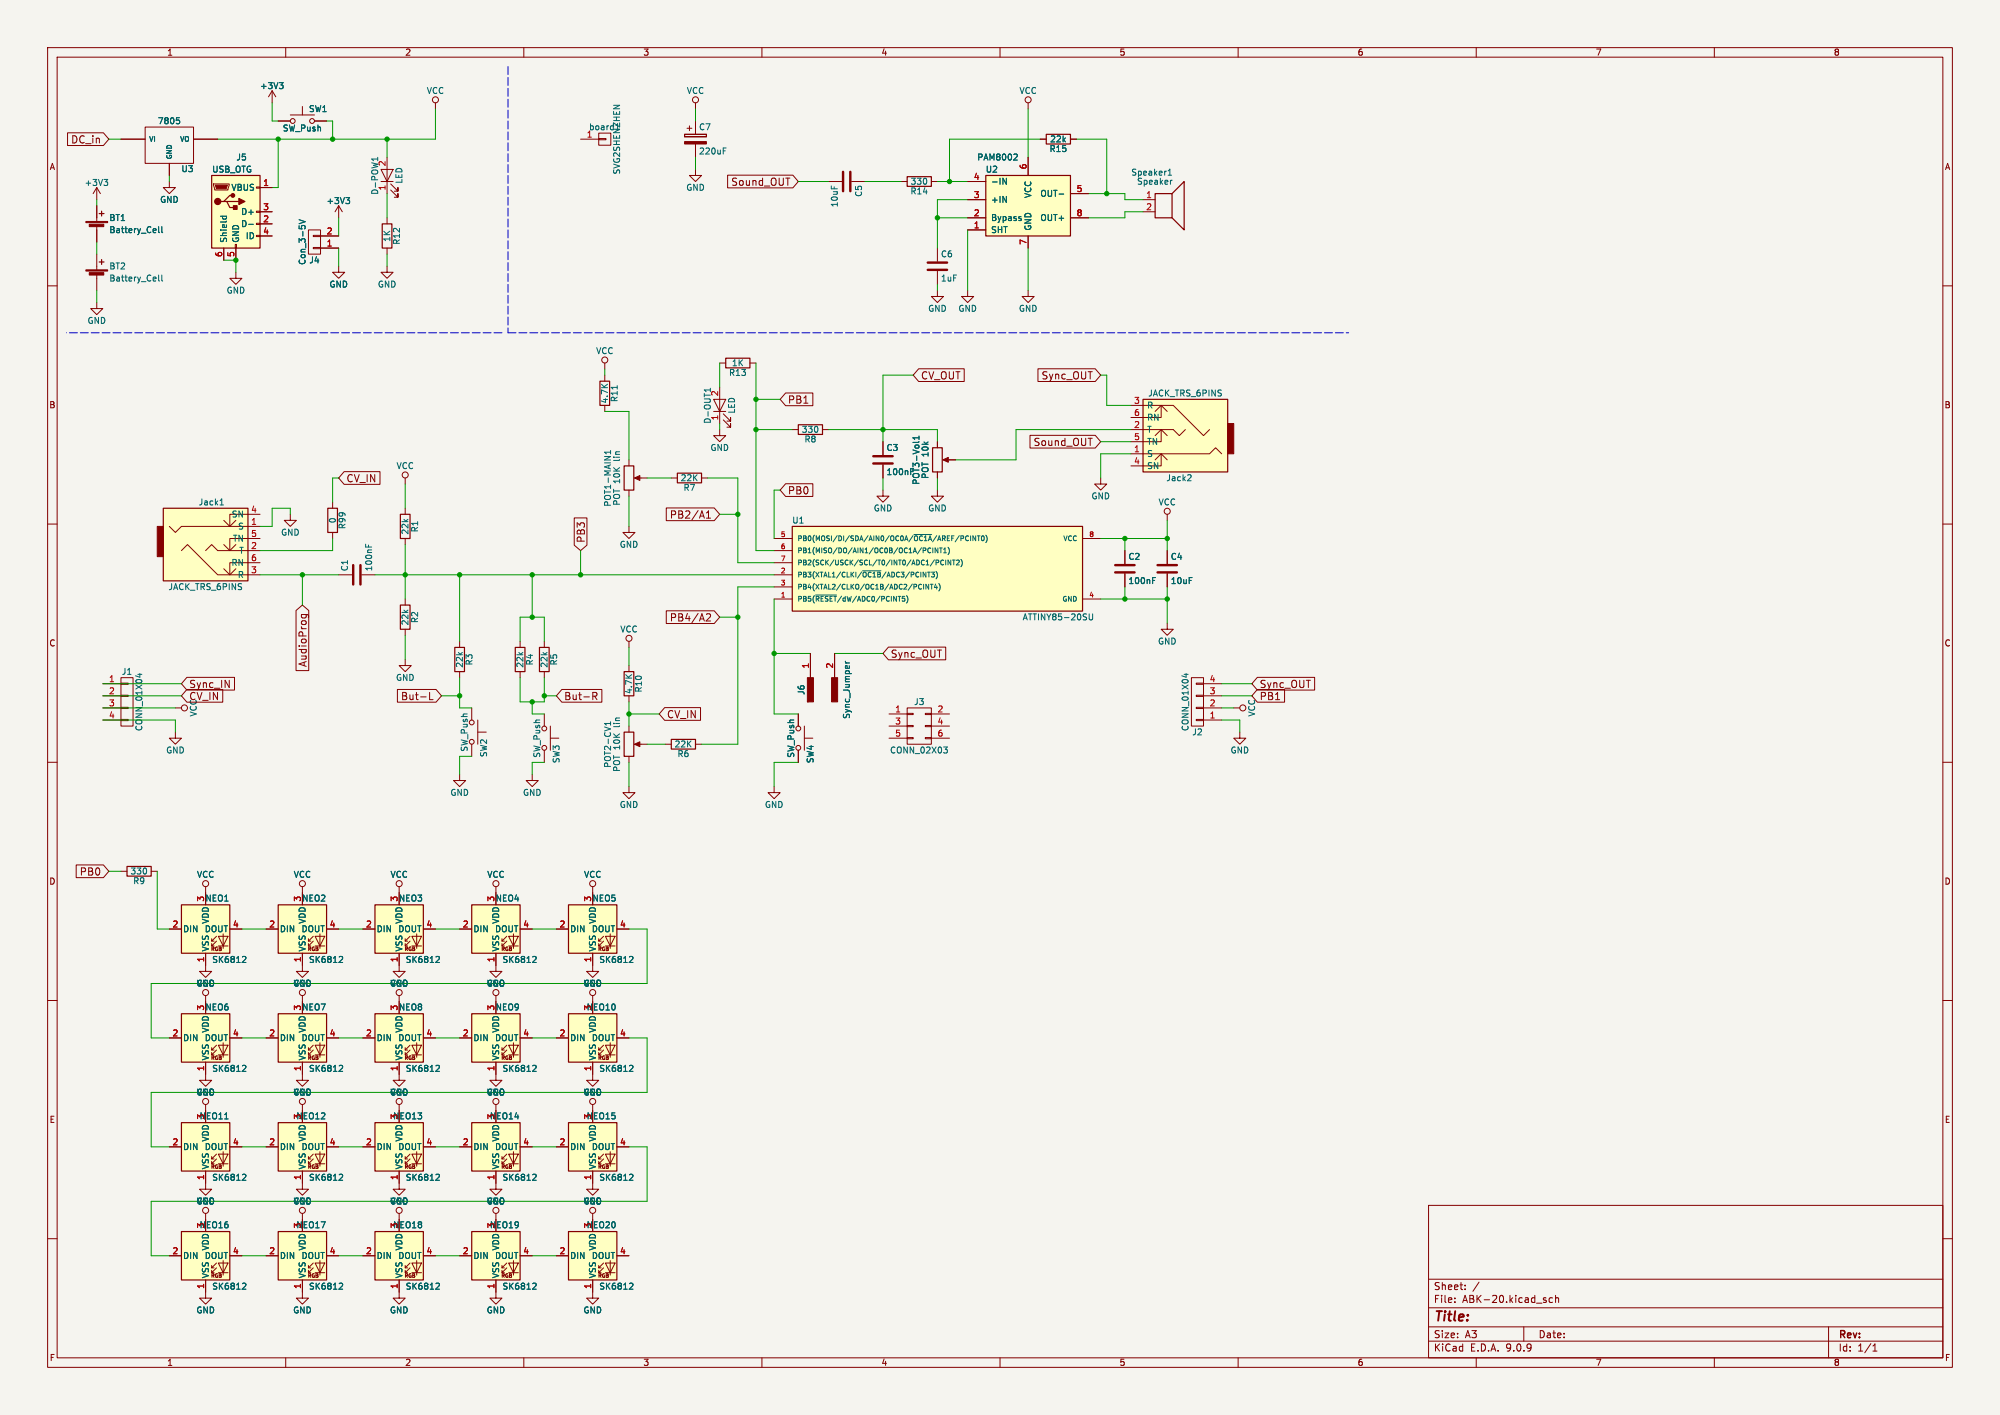
[picture p60: page 1]

Id: 1/1 Title: File: ABK-20.kicad_sch Sheet: /
