8BitMixtape/ABK-20/docs/ABK-20_native_schematic.pdf

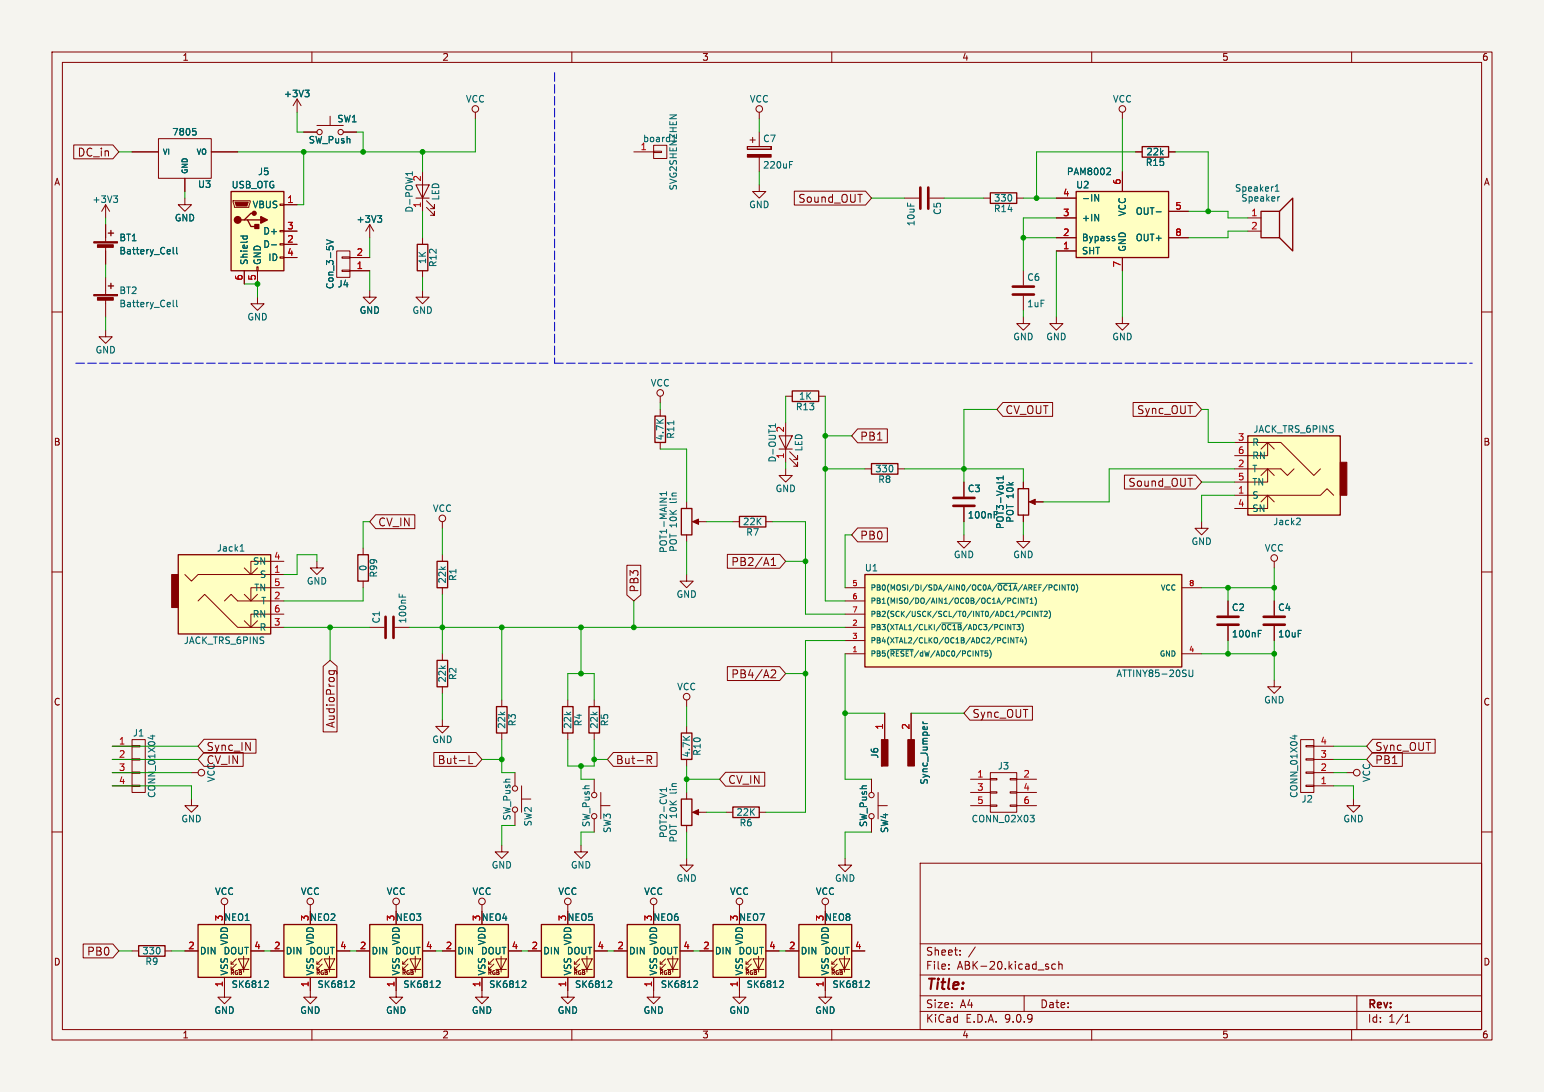
[picture p61: page 1]

1 DOUT 4 NEO6 SK6812 VCC GND GND

1 DOUT 4 VCC GND GND

Id: 1/1 Title: File: ABK-20.kicad_sch Sheet: / VCC
