8BitMixtape/ABK-20/docs/ABK-20_test_render.pdf

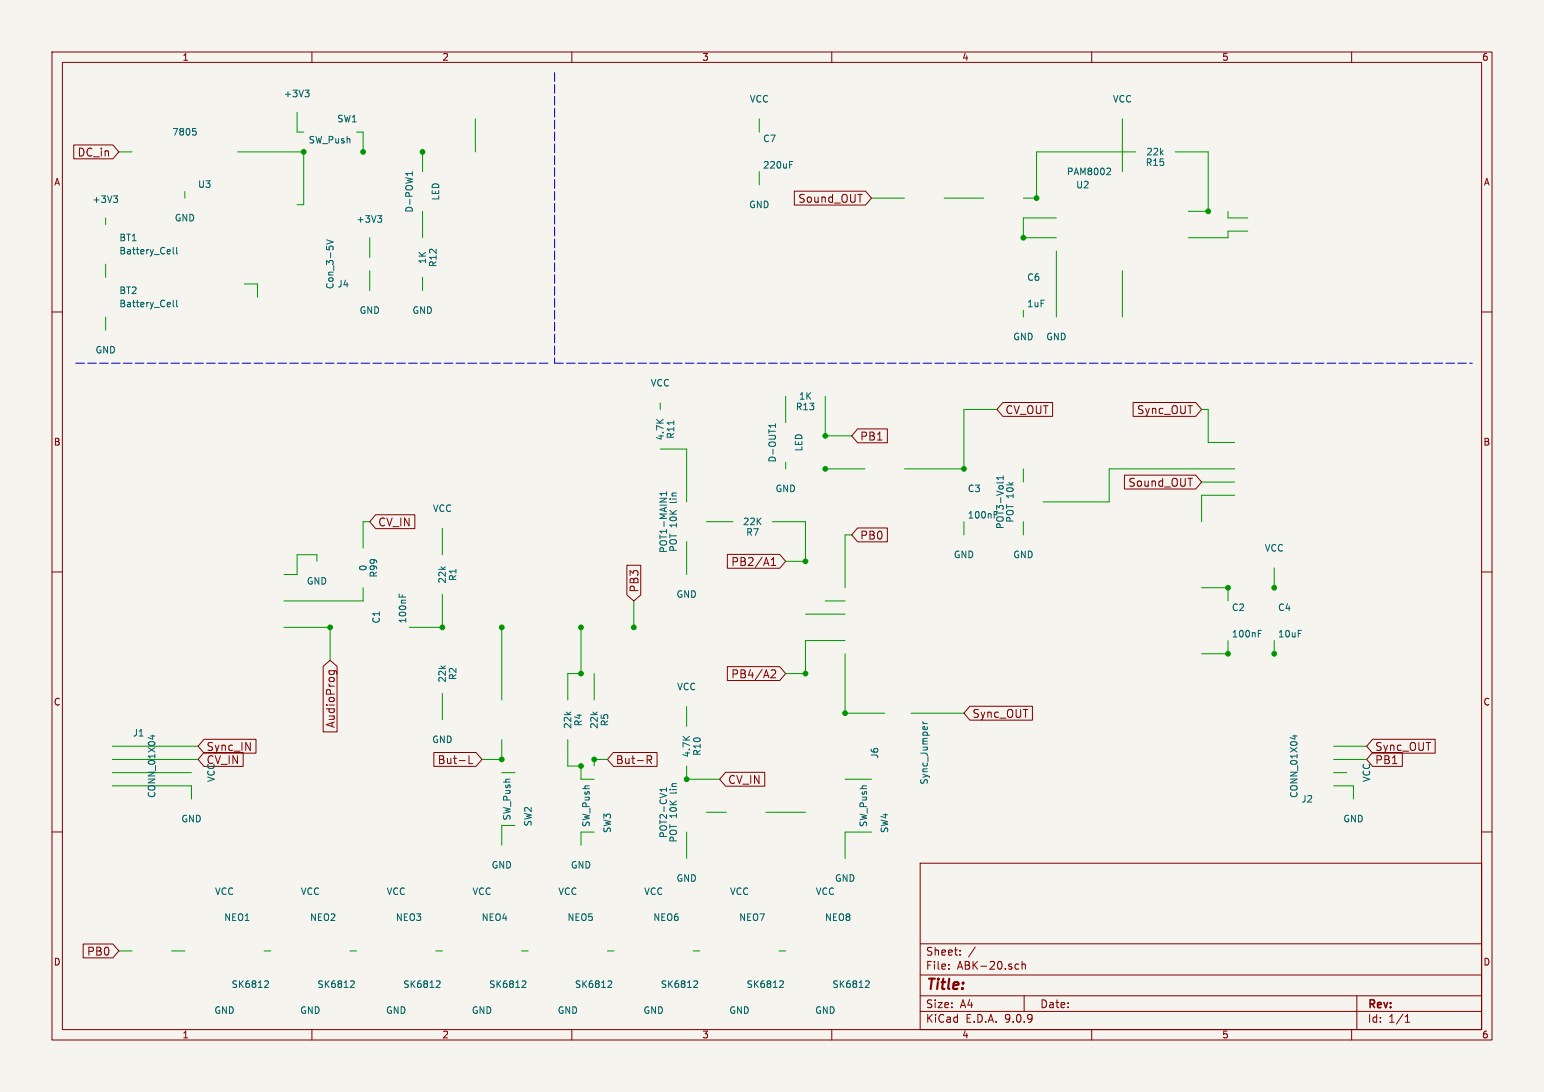
[picture p62: page 1]

Id: 1/1 Title: File: ABK-20.sch Sheet: / CV_IN
