8BitMixtape/ABK-20/docs/test_unprefixed.pdf

Id: 1/1 Title: File: ABK-20.sch Sheet: / CV_IN
