8BitMixtape/ABK-20/docs/test_rescue_plot.pdf

Id: 1/1 Title: File: ABK-20.sch Sheet: / CV_IN
