8BitMixtape/ABK-20/docs/schematic_preview.pdf

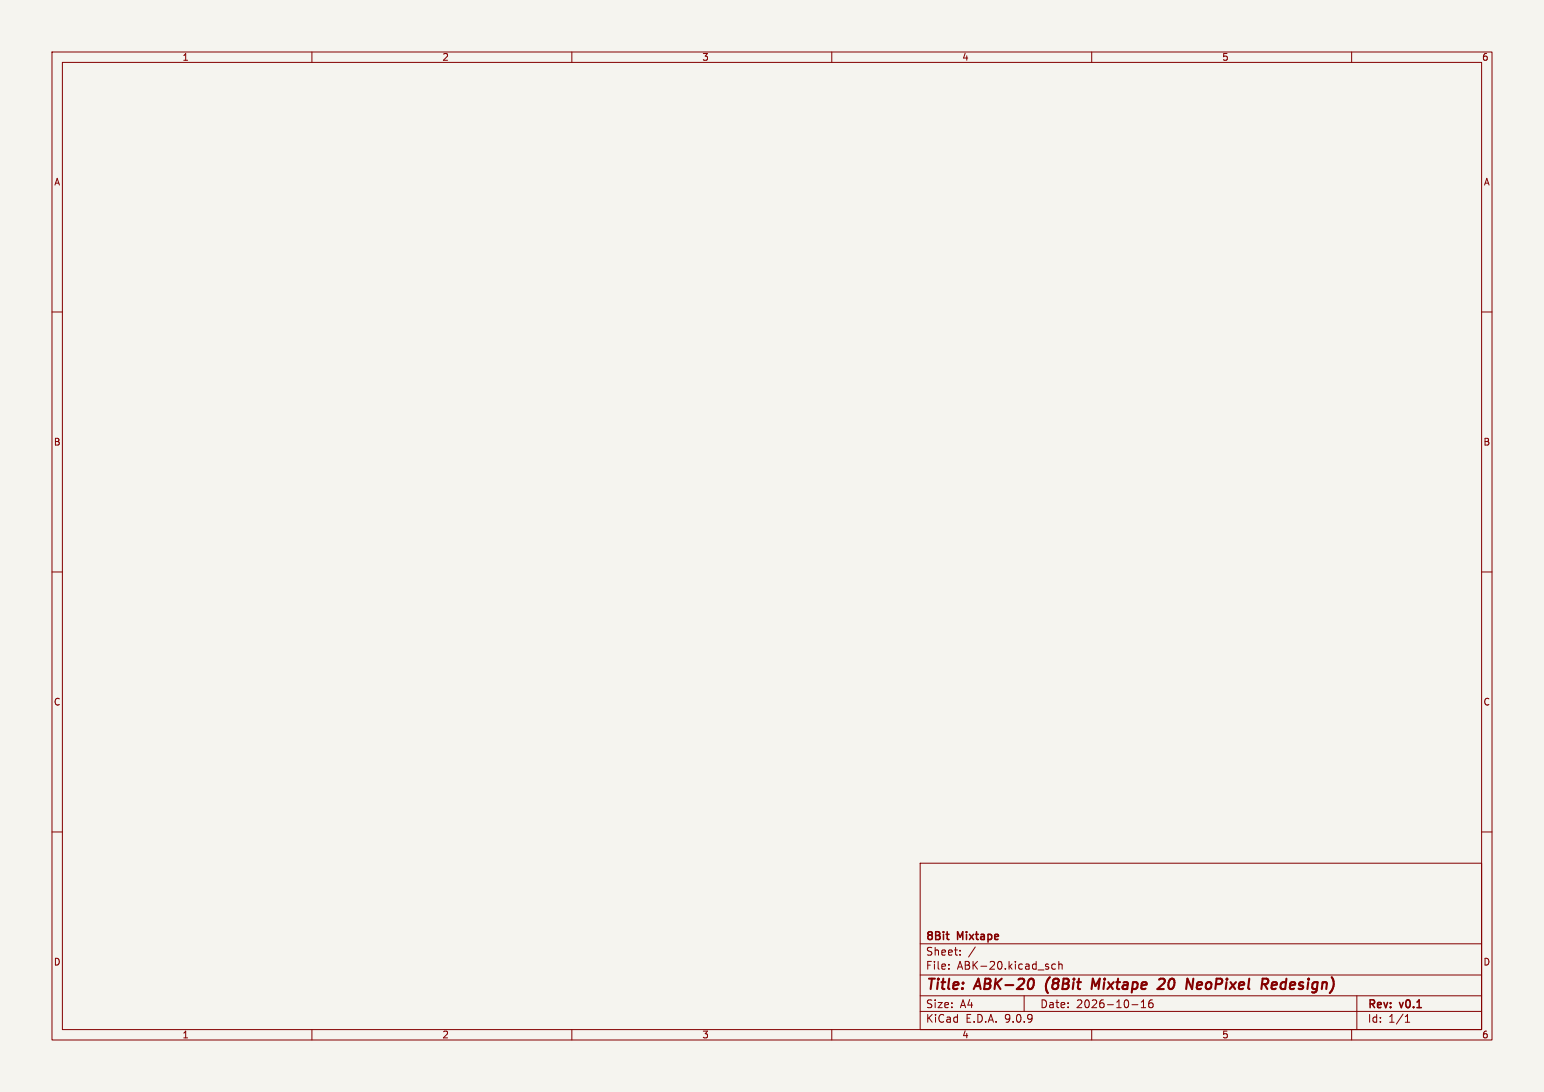
[picture p63: page 1]
