8BitMixtape/ABK-20/docs/fabrication/ABK-20_DIY_DRILL_HANDOUT.pdf

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

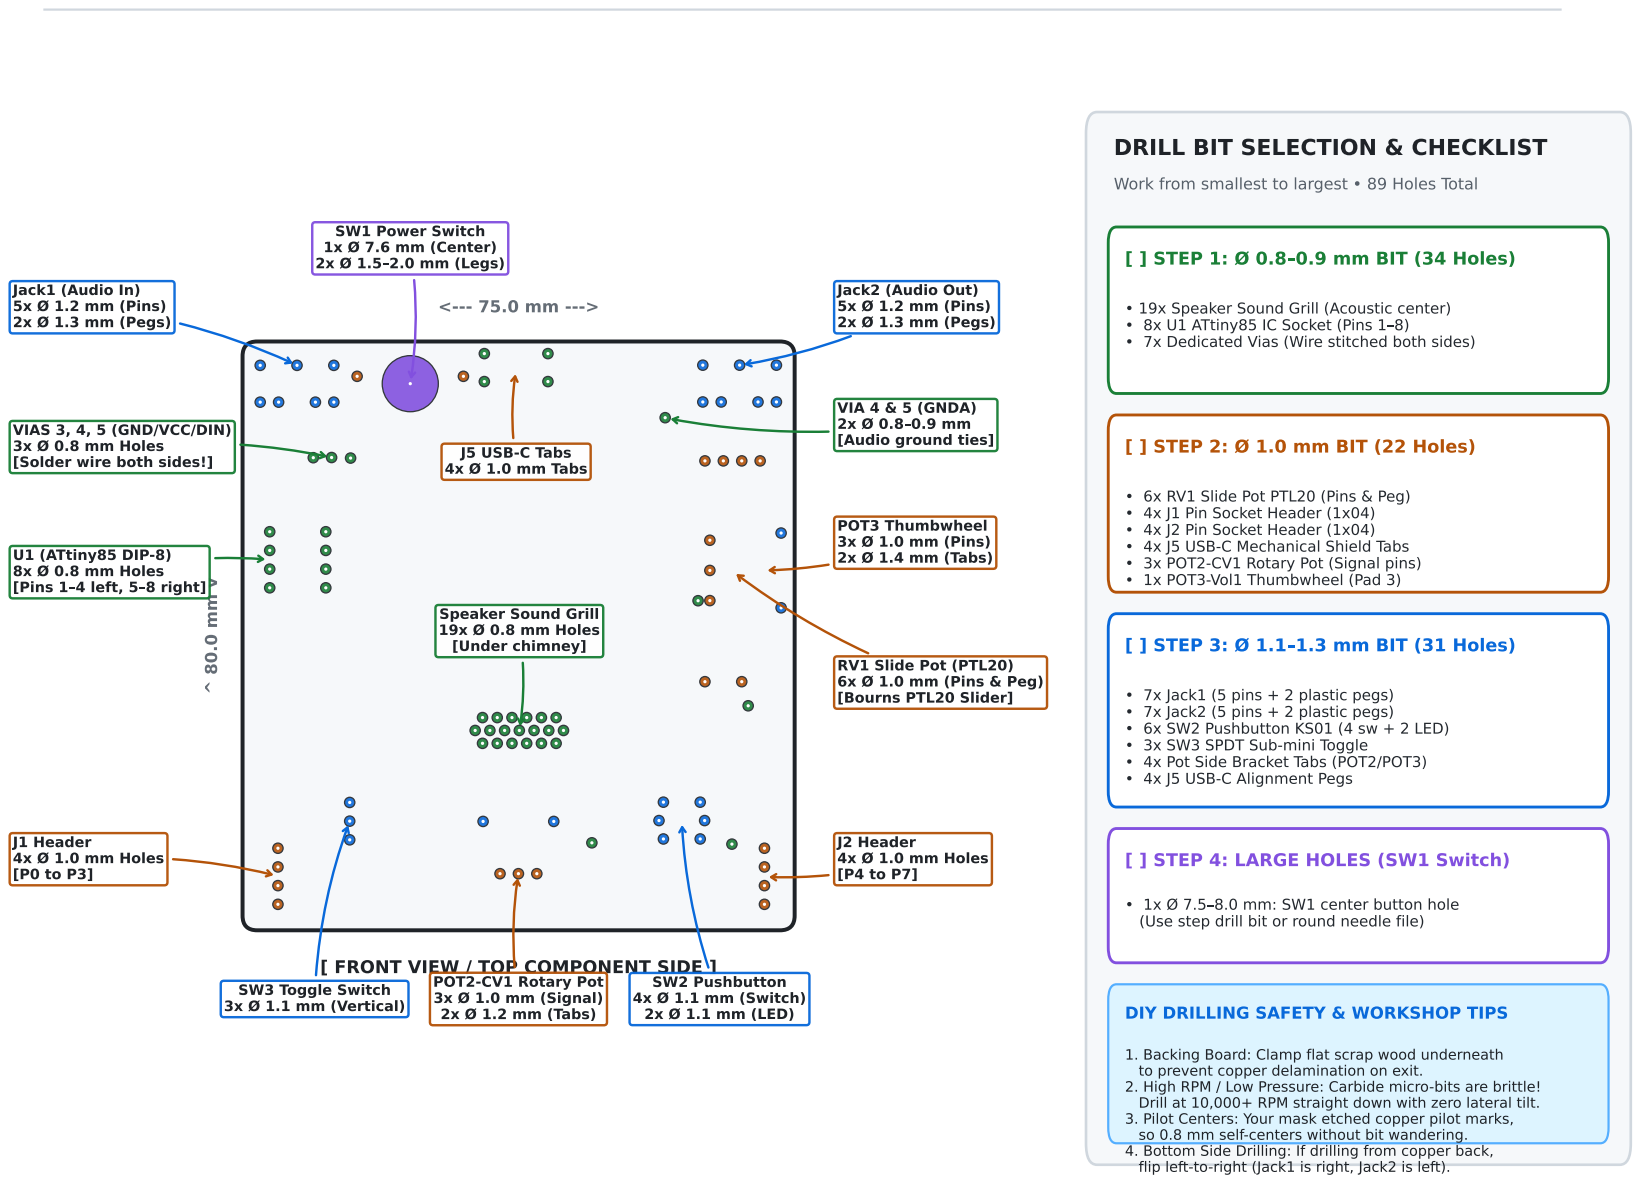
[picture p64: page 1]
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
