8BitMixtape/ABK-20/docs/clean_render.pdf

Id: 1/1 Title: File: ABK-20.sch Sheet: / CV_IN
