8BitMixtape/ABK-20/docs/ABK-20_pcb.pdf

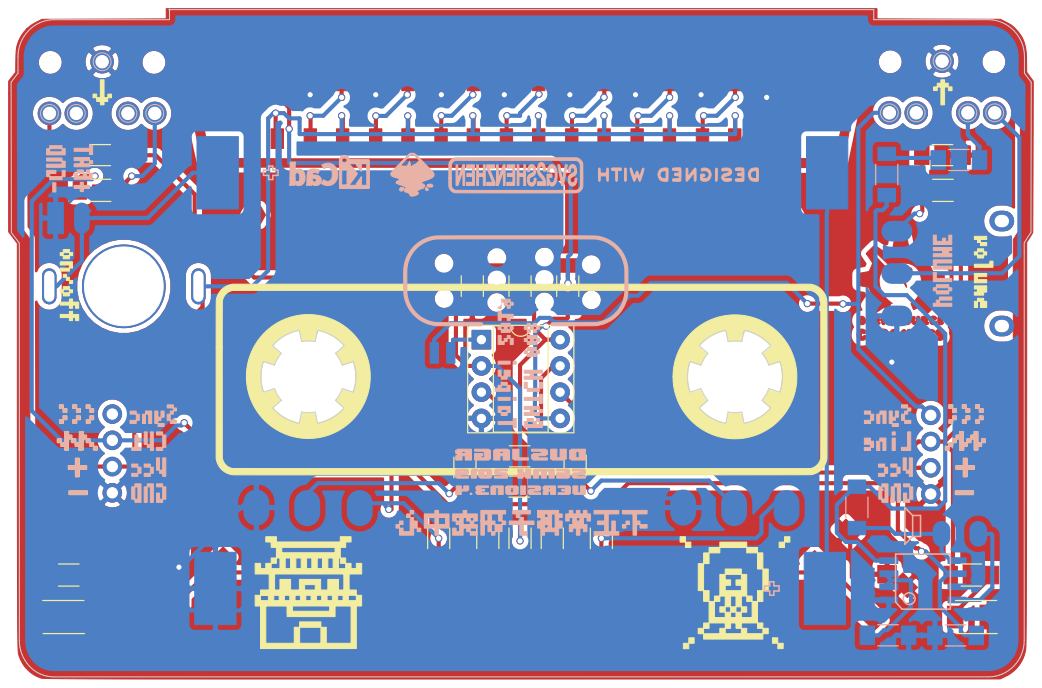
[picture p65: page 1]
