8BitMixtape/ABK-20/production/MASK/MASK_ABK-20-DIY-etch.pdf

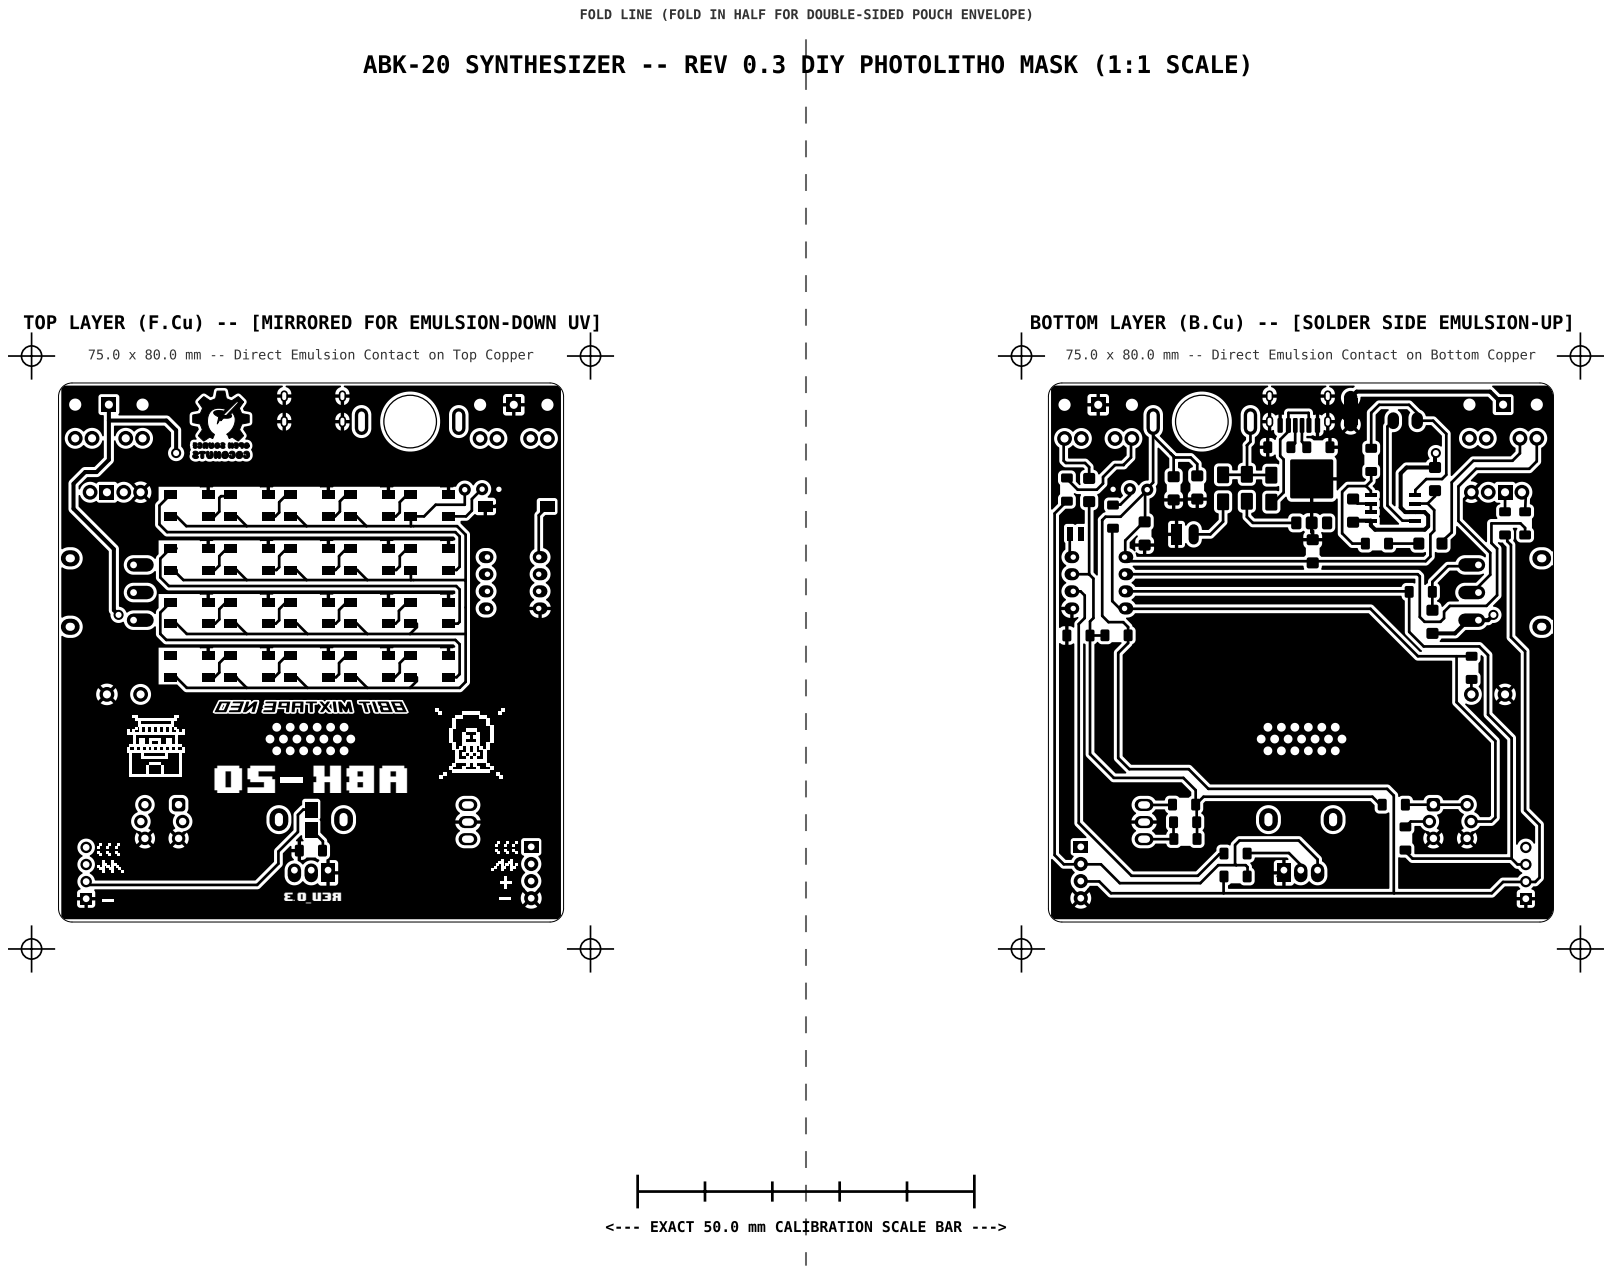
[picture p66: page 1]
ABK 2O; 3. o_ rEV
