8BitMixtape/ABK-20/production/MASK/ABK-20-DIY-etch.pdf

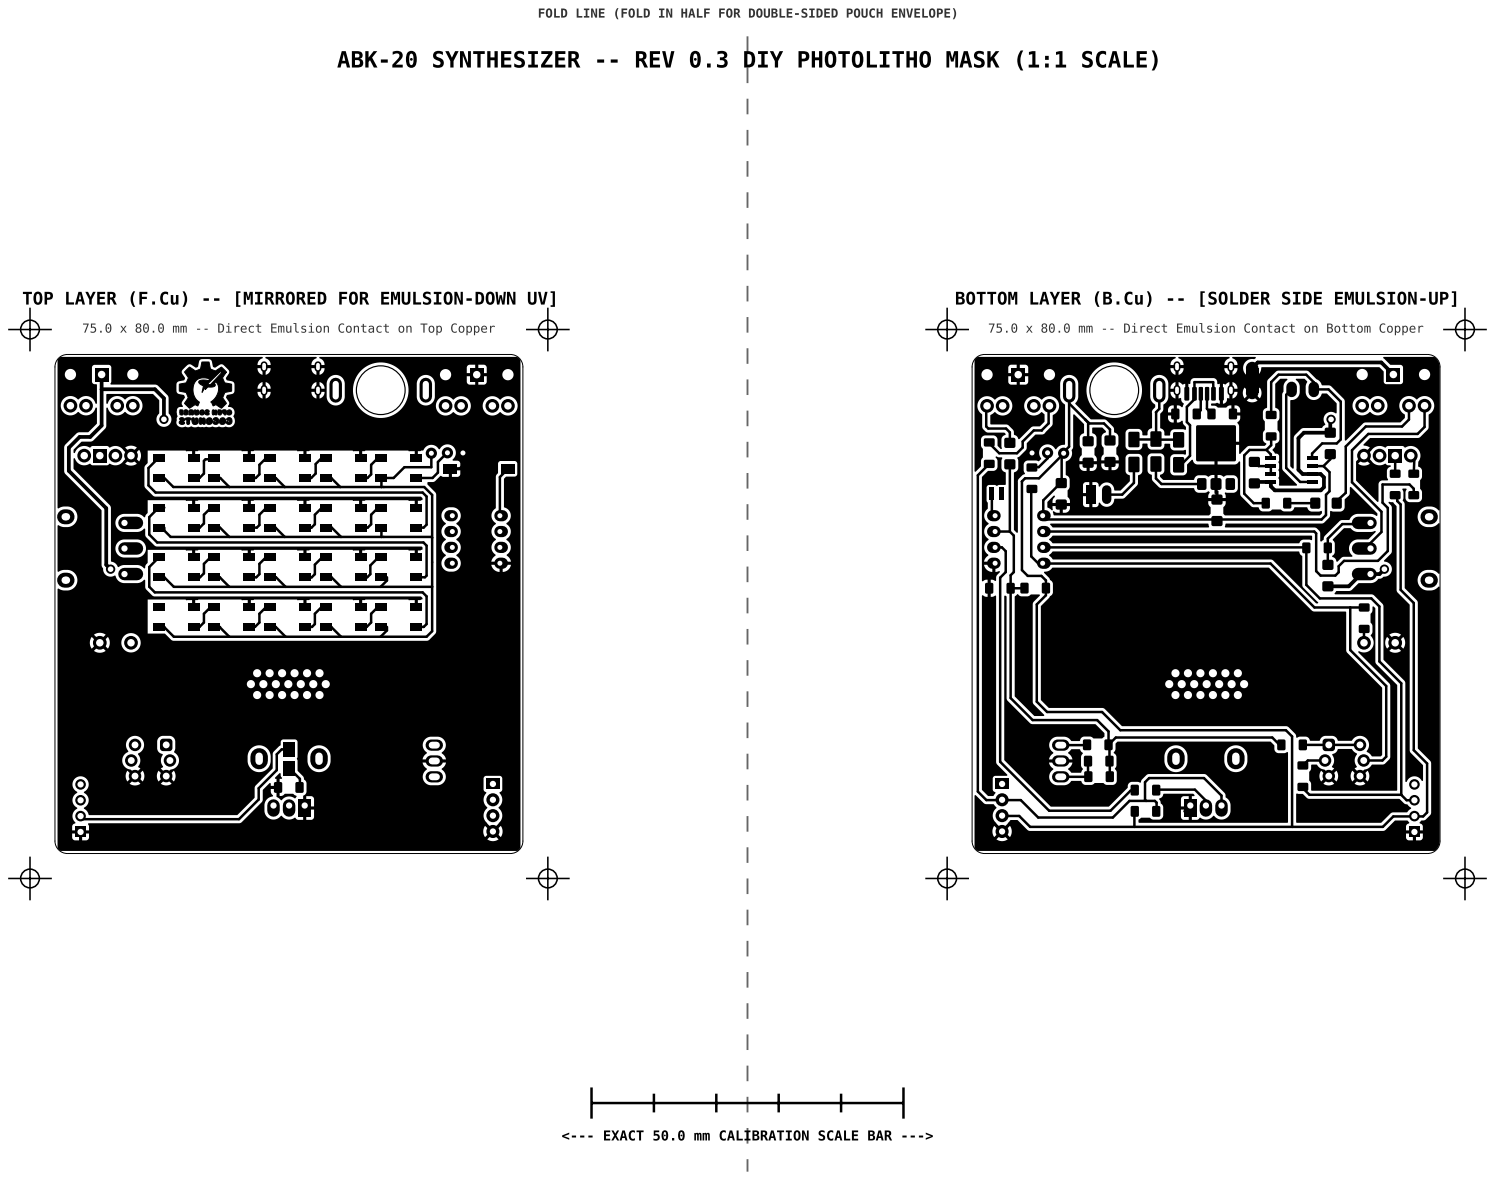
[picture p67: page 1]
