8BitMixtape/ABK-20/production/frontplate/output.pdf

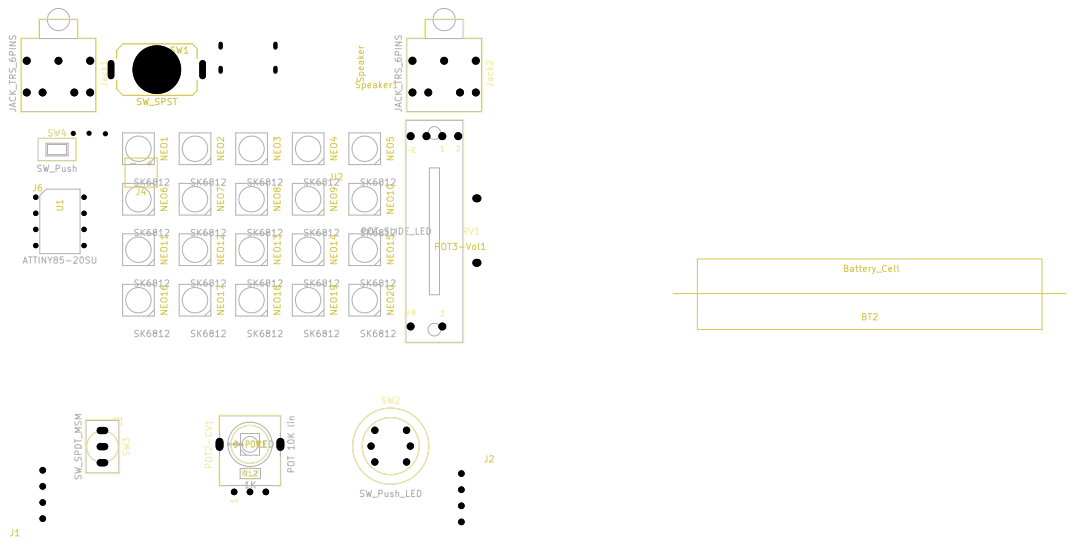
[picture p68: page 1]
