8BitMixtape/ABK-20/production/MASK/MASK_rev02_ABK-20-DIY-etch.pdf

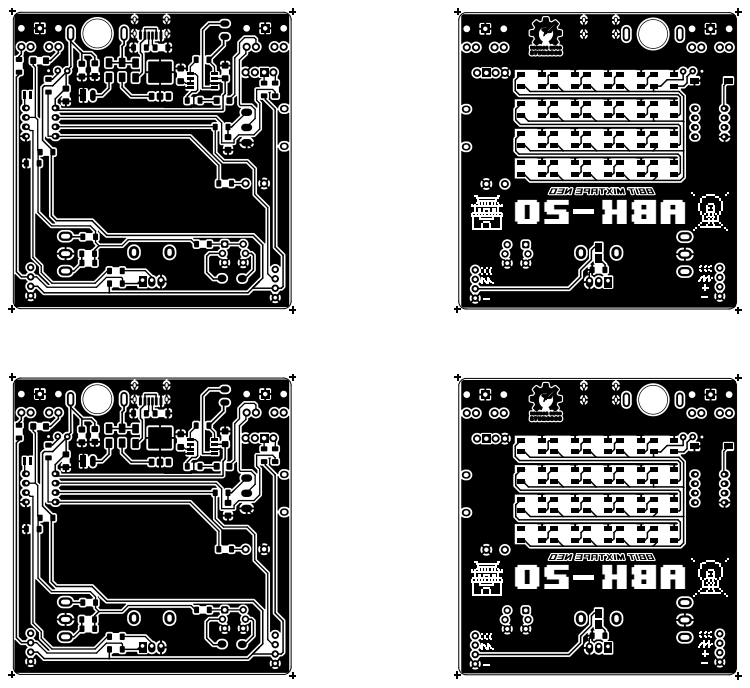
[picture p69: page 1]
ABK 2O
