8BitMixtape/ABK-20/production/MASK/MASK_rev03_ABK-20-DIY-etch.pdf

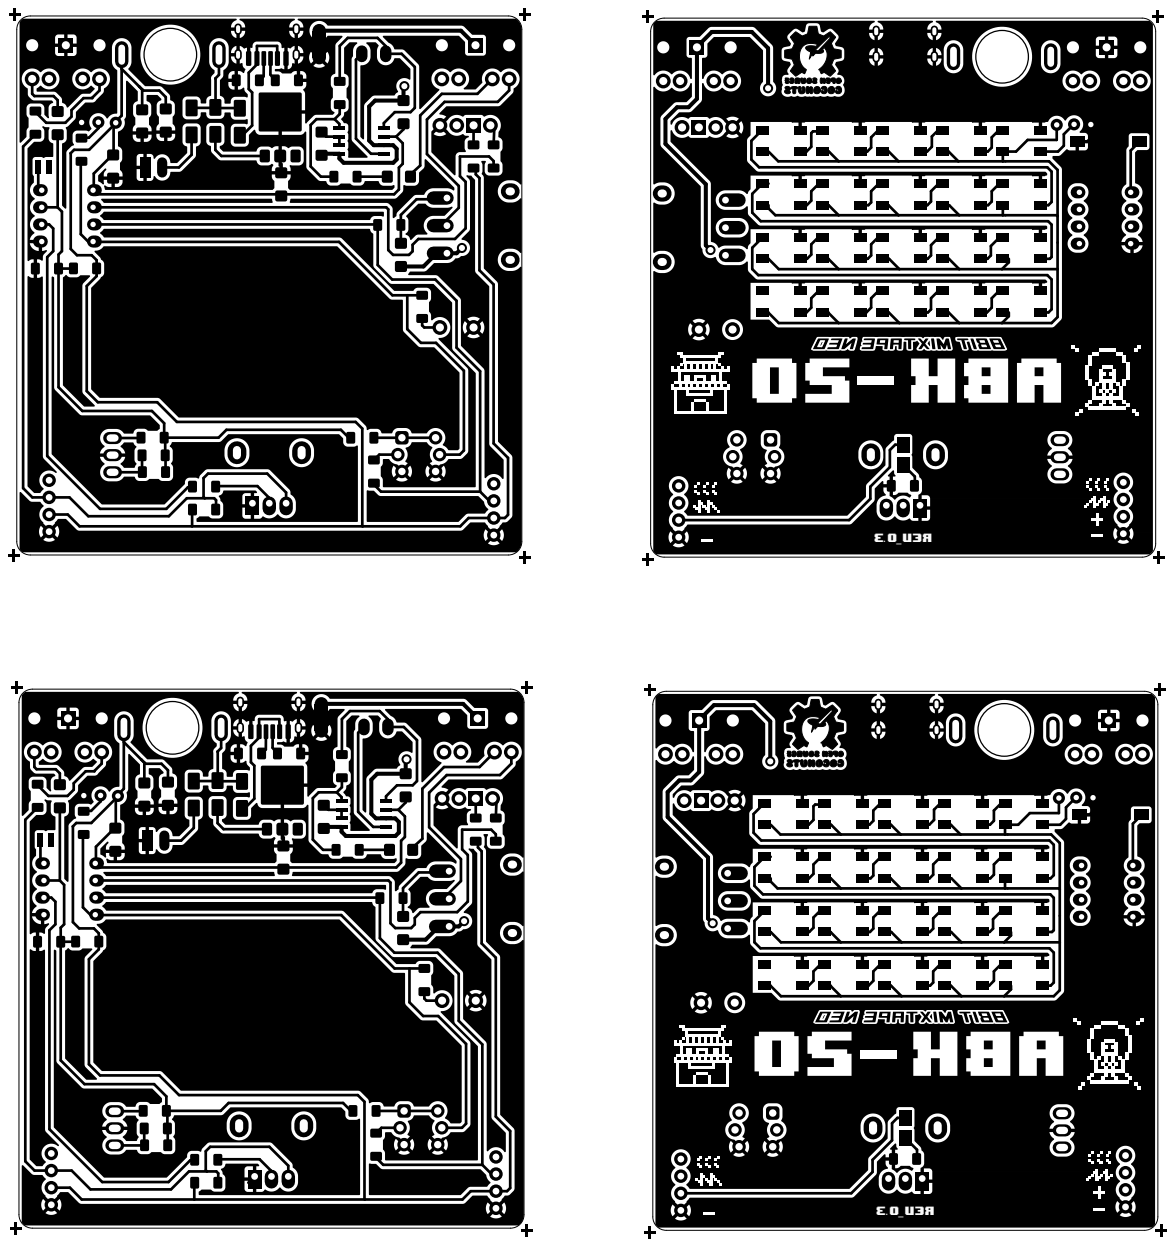
[picture p70: page 1]
ABK 2O; 3. o_ rEV
