8BitMixtape/ABK-20/hardware/ABK-20.kicad_pcb

## KiCad design hardware/ABK-20.kicad_pcb (2026-11-02)

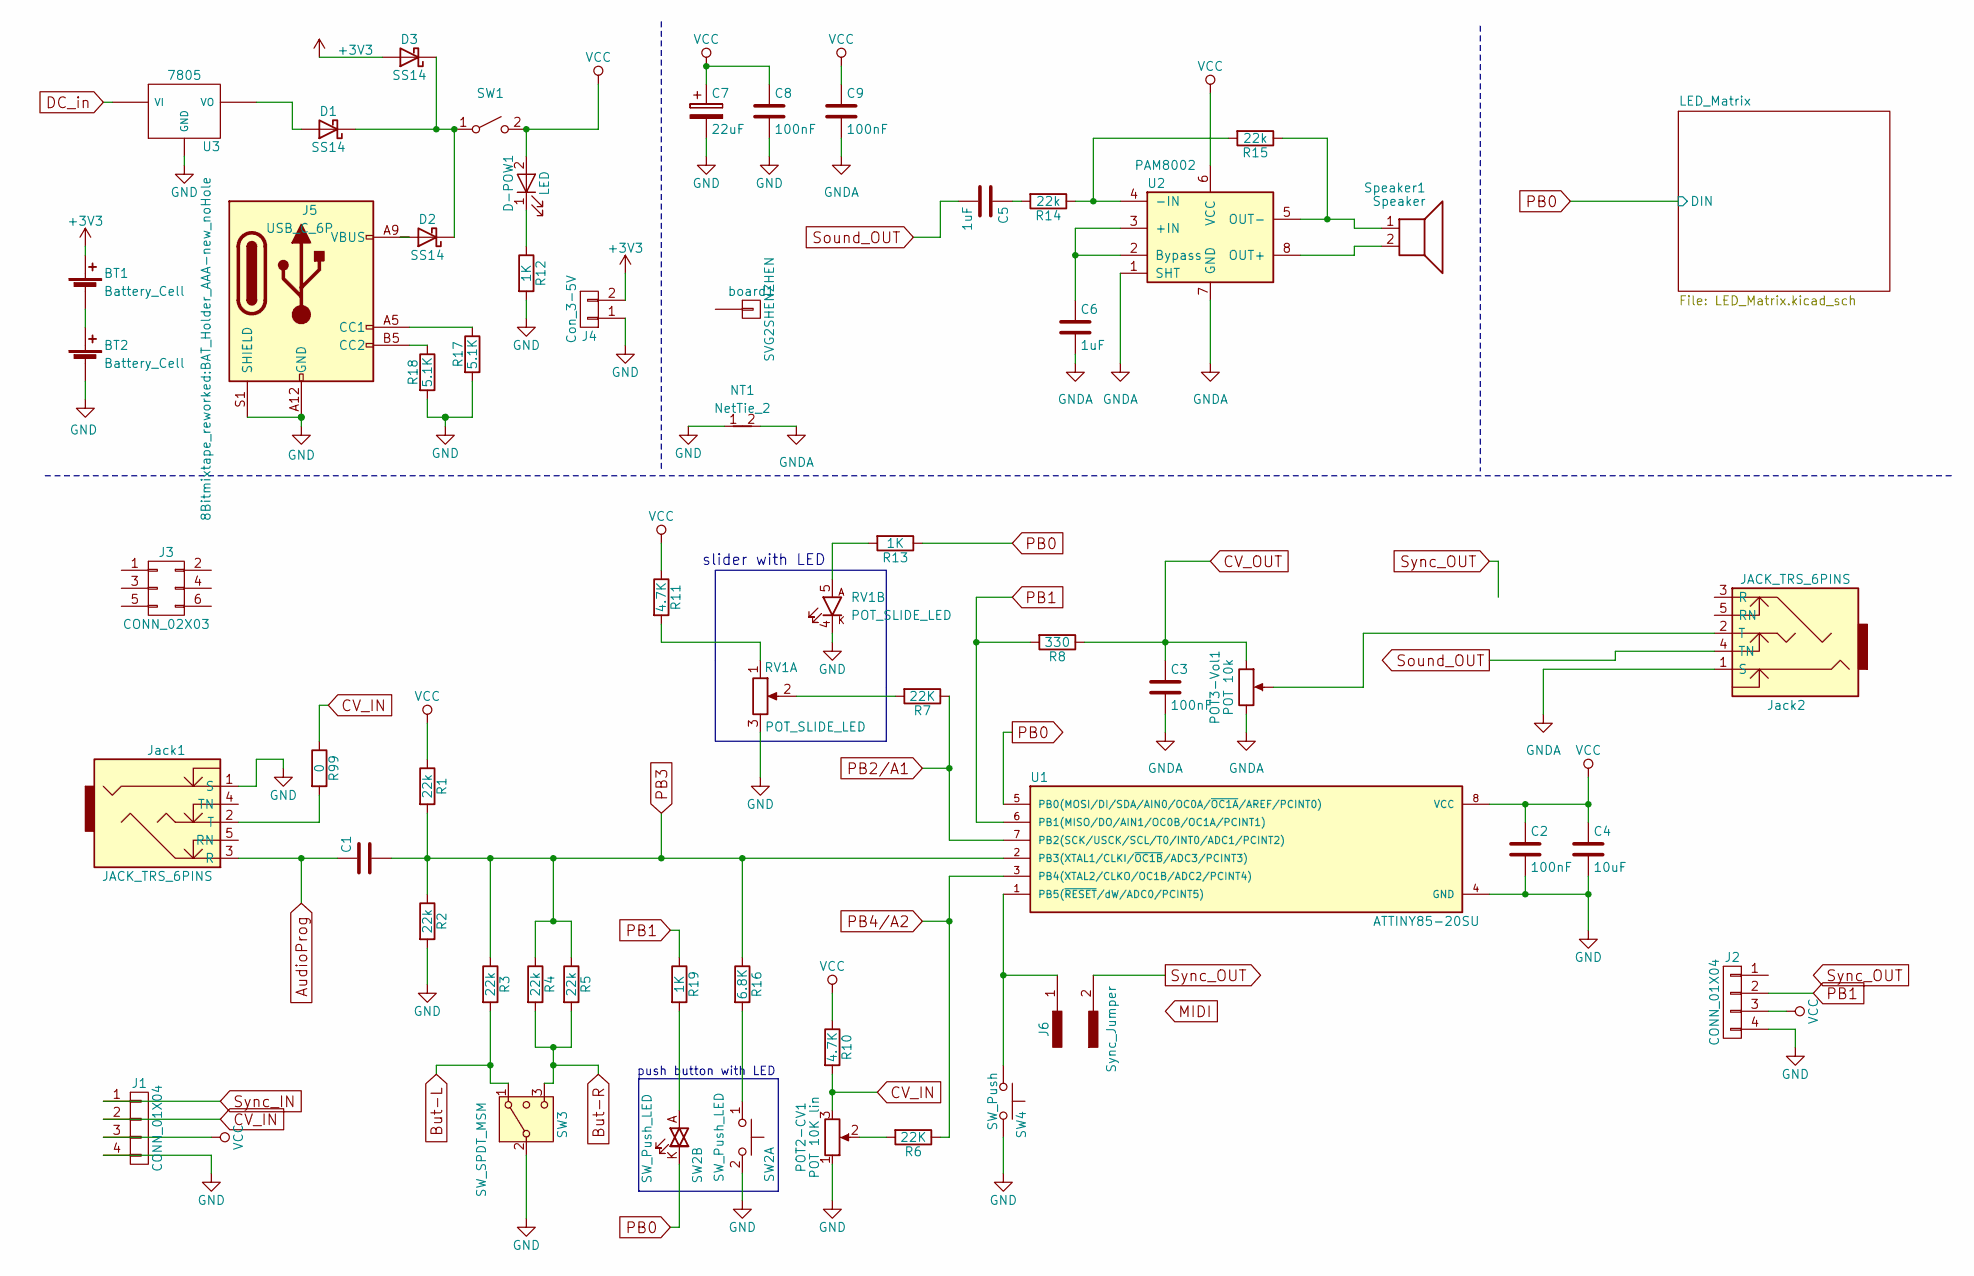
[picture p71: schematic ABK-20.kicad_sch]

Parts:
BT1, BT2: Battery_Cell; BAT_Holder_AAA-new_noHole
C1, C2, C3, C8, C9: 100nF; C_1210_noGND
C4: 10uF; C_1210_noGND
C5, C6: 1uF; C_1210_noGND
C7: 22uF; C_1210_noGND
D1, D2, D3: SS14; D_SMA
D-POW1: LED; LED_2835_minimal
J1: CONN_01X04; Angled_1x04_Pitch2.54mm-flip
J2: CONN_01X04; PinSocket_1x04_P2.54mm_Vertical
J3: CONN_02X03; Socket_Strip_Straight_2x03_Pitch2.54mm
J4: Con_3-5V; Bat_connector_SMD
J5: USB_C_6P; USB_C_6Pin_PowerOnly
J6: Sync_Jumper; Sync_jumper_small
Jack1, Jack2: JACK_TRS_6PINS; AUDIO-Jack_3.5mm_PJ-317
NT1: NetTie_2; NetTie-2_SMD_Pad2.0mm
POT2-CV1: POT 10K lin; Potentiometer_RV09_Vertical_ClearShaft
POT3-Vol1: POT 10k; Potentiometer_wheel
R1, R2, R3, R4, R5, R14, R15: 22k; R_1206_noGND_sm
R6, R7: 22K; R_1206_noGND_sm
R8: 330; R_1206_noGND_sm
R10, R11: 4.7K; R_1206_noGND_sm
R12, R13, R19: 1K; R_1206_noGND_sm
R16: 6.8K; R_1206_noGND_sm
R17, R18: 5.1K; R_1206_noGND_sm
R99: 0; R_1206_noGND_sm
RV1: POT_SLIDE_LED; Potentiometer_Bourns_PTL20_Single_Slide_LED
SW1: SW_SPST; Push_SWITCH_hole
SW2: SW_Push_LED; SW_Push_Highly_KS01-BL-13
SW3: SW_SPDT_MSM; SW_Toggle_SPDT_SubMini_SMTS-103
SW4: SW_Push; SW_SPST_FSMSM
Speaker1: Speaker; SpeakerPads_SMD
U1: ATTINY85-20SU; Attiny_DIP-8_W7.62mm_mod
U2: PAM8002; SO-8_fixed
U3: 7805; TO-252-3_TabPin2
board1: SVG2SHENZHEN; Mixtape_reworked

Connections:
+3V3: BT1.1 (+), D3.2 (A), J4.2
AudioProg: C1.1, Jack1.3 (R)
But-L: R3.2, SW3.1
But-R: R4.2, R5.2, SW3.3 (4)
CV_IN: J1.2, POT2-CV1.3, R10.2, R99.1
CV_OUT: C3.1, POT3-Vol1.1, R8.1
DC_in: U3.1 (VI)
GND: BT2.2 (-), C2.2, C4.2, C7.2, C8.2, J1.4, J2.4, J4.1, J5.A12 (GND), J5.B12 (GND), J5.S1 (SHIELD), Jack1.1 (S), NT1.1, POT2-CV1.1, R2.2, R12.2, R17.2, R18.2, RV1.3, RV1.4 (K), SW2.2, SW3.2 (3), SW4.2, U1.4 (GND), U3.2 (GND); also elsewhere on the board
GNDA: C3.2, C6.2, C9.2, Jack2.1 (S), NT1.2, POT3-Vol1.3, U2.1 (SHT), U2.7 (GND)
unnamed: BT1.2 (-), BT2.1 (+)
unnamed: C5.1, R14.2
unnamed: D1.2 (A), U3.3 (VO)
unnamed: D1.1 (K), D2.1 (K), D3.1 (K), SW1.1 (A)
unnamed: D2.2 (A), J5.A9 (VBUS), J5.B9 (VBUS)
unnamed: D-POW1.1 (K), R12.1
unnamed: J5.A5 (CC1), R17.1
unnamed: J5.B5 (CC2), R18.1
unnamed: Jack1.2 (T), R99.2
unnamed: Jack2.2 (T), POT3-Vol1.2
unnamed: POT2-CV1.2, R6.2
unnamed: R7.2, RV1.2
unnamed: R11.2, RV1.1
unnamed: R16.2, SW2.1
unnamed: R19.2, SW2.A
unnamed: R13.2, RV1.5 (A)
unnamed: J6.1, SW4.1, U1.1 (PB5(~RESET/dW/ADC0/PCINT5))
unnamed: C6.1, U2.2 (Bypass), U2.3 (+IN)
unnamed: R14.1, R15.2, U2.4 (-IN)
unnamed: Speaker1.2, U2.8 (OUT+)
unnamed: R15.1, Speaker1.1, U2.5 (OUT-)
PB0: R13.1, SW2.K, U1.5 (PB0(MOSI/DI/SDA/AIN0/OC0A/~OC1A/AREF/PC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); also elsewhere on the board
PB1: J2.2, R8.2, R19.1, U1.6 (PB1(MISO/DO/AIN1/OC0B/OC1A/PCINT1))
PB2/A1: R7.1, U1.7 (PB2(SCK/USCK/SCL/T0/INT0/ADC1/PCINT2))
PB3: C1.2, R1.2, R2.1, R3.1, R4.1, R5.1, R16.1, U1.2 (PB3(XTAL1/CLKI/~OC1B/ADC3/PCINT3))
PB4/A2: R6.1, U1.3 (PB4(XTAL2/CLKO/OC1B/ADC2/PCINT4))
Sound_OUT: C5.2, Jack2.4 (TN)
Sync_IN: J1.1
Sync_OUT: J6.2
VCC: C2.1, C4.1, C7.1, C8.1, C9.1, D-POW1.2 (A), J1.3, J2.3, R1.1, R10.1, R11.1, SW1.2 (B), U1.8 (VCC), U2.6 (VCC); also elsewhere on the board

Notes on the sheet:
slider with LED
push button with LED

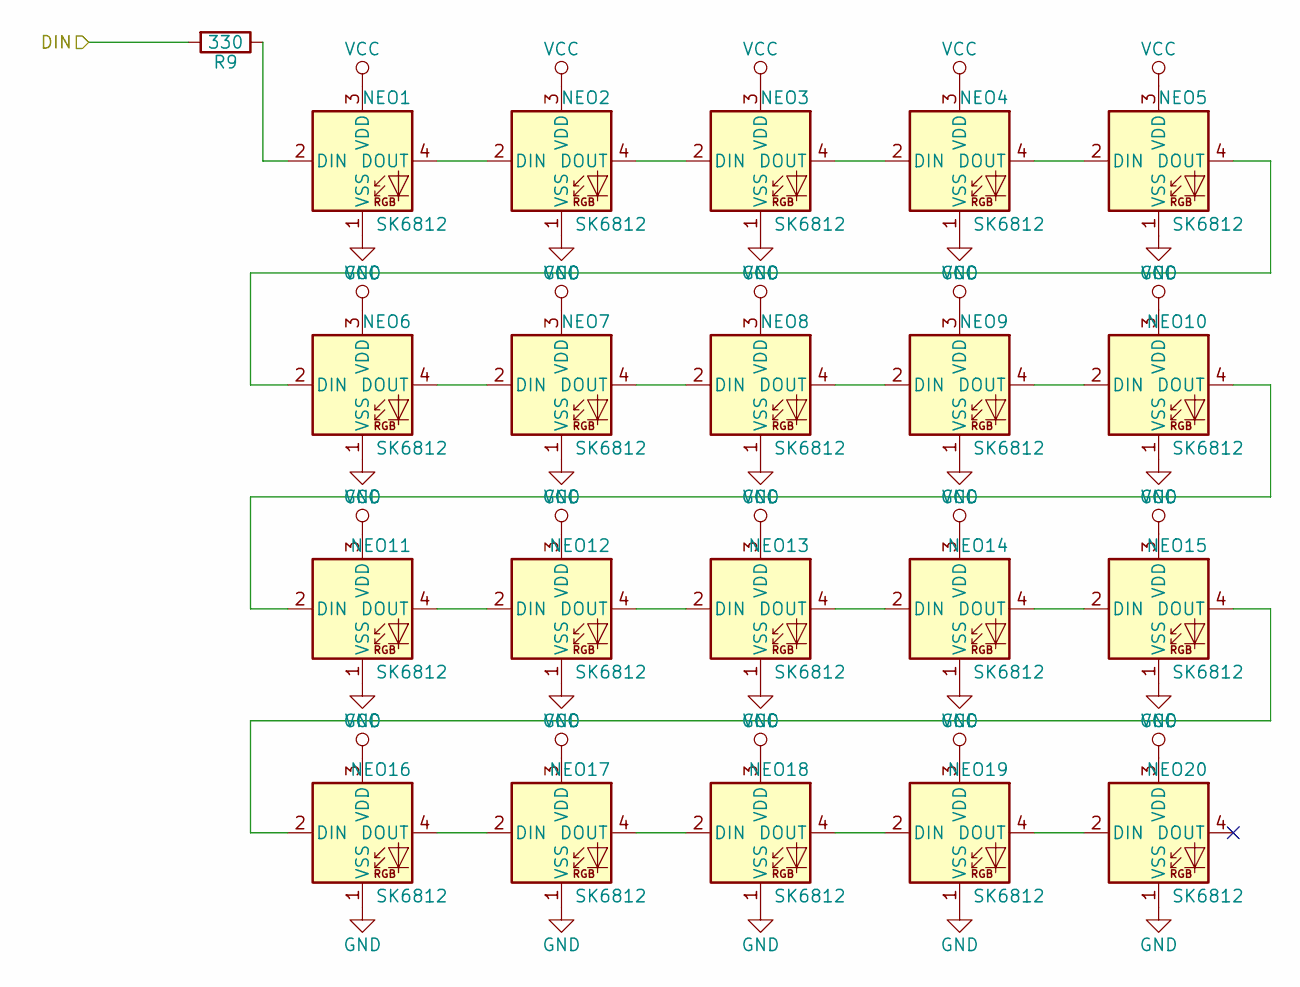
[picture p72: schematic LED_Matrix.kicad_sch]

Parts:
NEO1, NEO2, NEO3, NEO4, NEO5, NEO6, NEO7, NEO8, NEO9, NEO10, NEO11, NEO12, NEO13, NEO14, NEO15, NEO16, NEO17, NEO18, NEO19, NEO20: SK6812; Mixtape_NEO_WS2812B
R9: 330; R_1206_noGND_sm

Connections:
GND: NEO1.1 (VSS), NEO2.1 (VSS), NEO3.1 (VSS), NEO4.1 (VSS), NEO5.1 (VSS), NEO6.1 (VSS), NEO7.1 (VSS), NEO8.1 (VSS), NEO9.1 (VSS), NEO10.1 (VSS), NEO11.1 (VSS), NEO12.1 (VSS), NEO13.1 (VSS), NEO14.1 (VSS), NEO15.1 (VSS), NEO16.1 (VSS), NEO17.1 (VSS), NEO18.1 (VSS), NEO19.1 (VSS), NEO20.1 (VSS); also elsewhere on the board
unnamed: NEO1.2 (DIN), R9.1
unnamed: NEO1.4 (DOUT), NEO2.2 (DIN)
unnamed: NEO2.4 (DOUT), NEO3.2 (DIN)
unnamed: NEO3.4 (DOUT), NEO4.2 (DIN)
unnamed: NEO4.4 (DOUT), NEO5.2 (DIN)
unnamed: NEO5.4 (DOUT), NEO6.2 (DIN)
unnamed: NEO6.4 (DOUT), NEO7.2 (DIN)
unnamed: NEO7.4 (DOUT), NEO8.2 (DIN)
unnamed: NEO8.4 (DOUT), NEO9.2 (DIN)
unnamed: NEO9.4 (DOUT), NEO10.2 (DIN)
unnamed: NEO10.4 (DOUT), NEO11.2 (DIN)
unnamed: NEO11.4 (DOUT), NEO12.2 (DIN)
unnamed: NEO12.4 (DOUT), NEO13.2 (DIN)
unnamed: NEO13.4 (DOUT), NEO14.2 (DIN)
unnamed: NEO14.4 (DOUT), NEO15.2 (DIN)
unnamed: NEO15.4 (DOUT), NEO16.2 (DIN)
unnamed: NEO16.4 (DOUT), NEO17.2 (DIN)
unnamed: NEO17.4 (DOUT), NEO18.2 (DIN)
unnamed: NEO18.4 (DOUT), NEO19.2 (DIN)
unnamed: NEO19.4 (DOUT), NEO20.2 (DIN)
PB0: R9.2; also elsewhere on the board
VCC: NEO1.3 (VDD), NEO2.3 (VDD), NEO3.3 (VDD), NEO4.3 (VDD), NEO5.3 (VDD), NEO6.3 (VDD), NEO7.3 (VDD), NEO8.3 (VDD), NEO9.3 (VDD), NEO10.3 (VDD), NEO11.3 (VDD), NEO12.3 (VDD), NEO13.3 (VDD), NEO14.3 (VDD), NEO15.3 (VDD), NEO16.3 (VDD), NEO17.3 (VDD), NEO18.3 (VDD), NEO19.3 (VDD), NEO20.3 (VDD); also elsewhere on the board

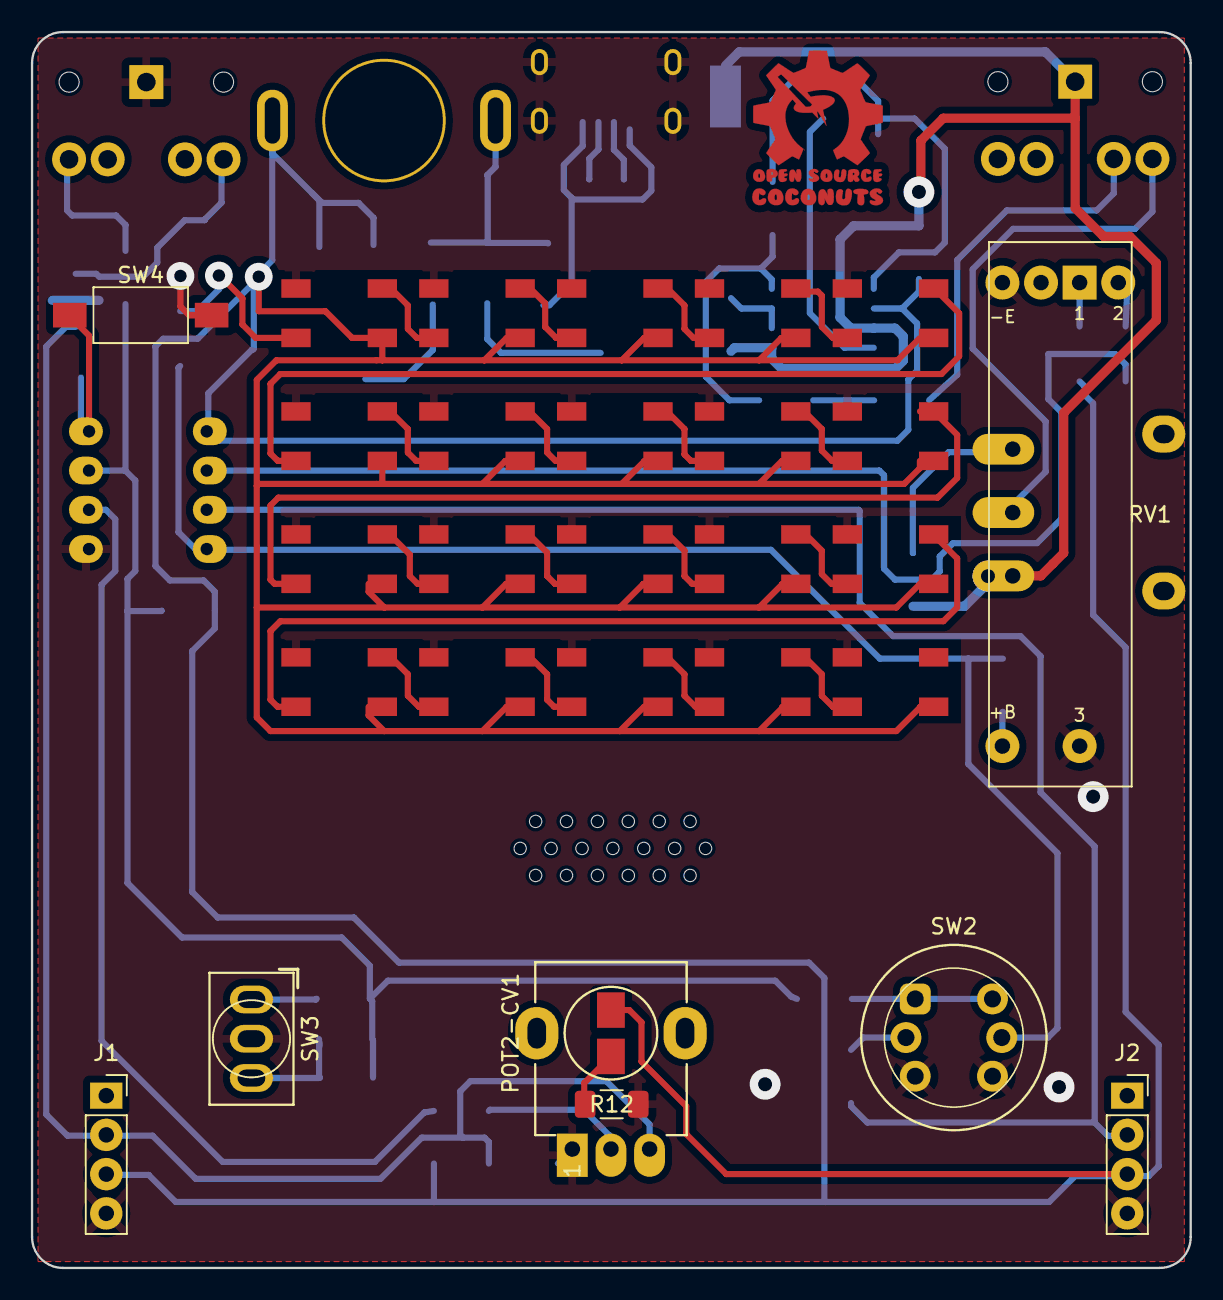
[picture p73: board ABK-20.kicad_pcb from above]

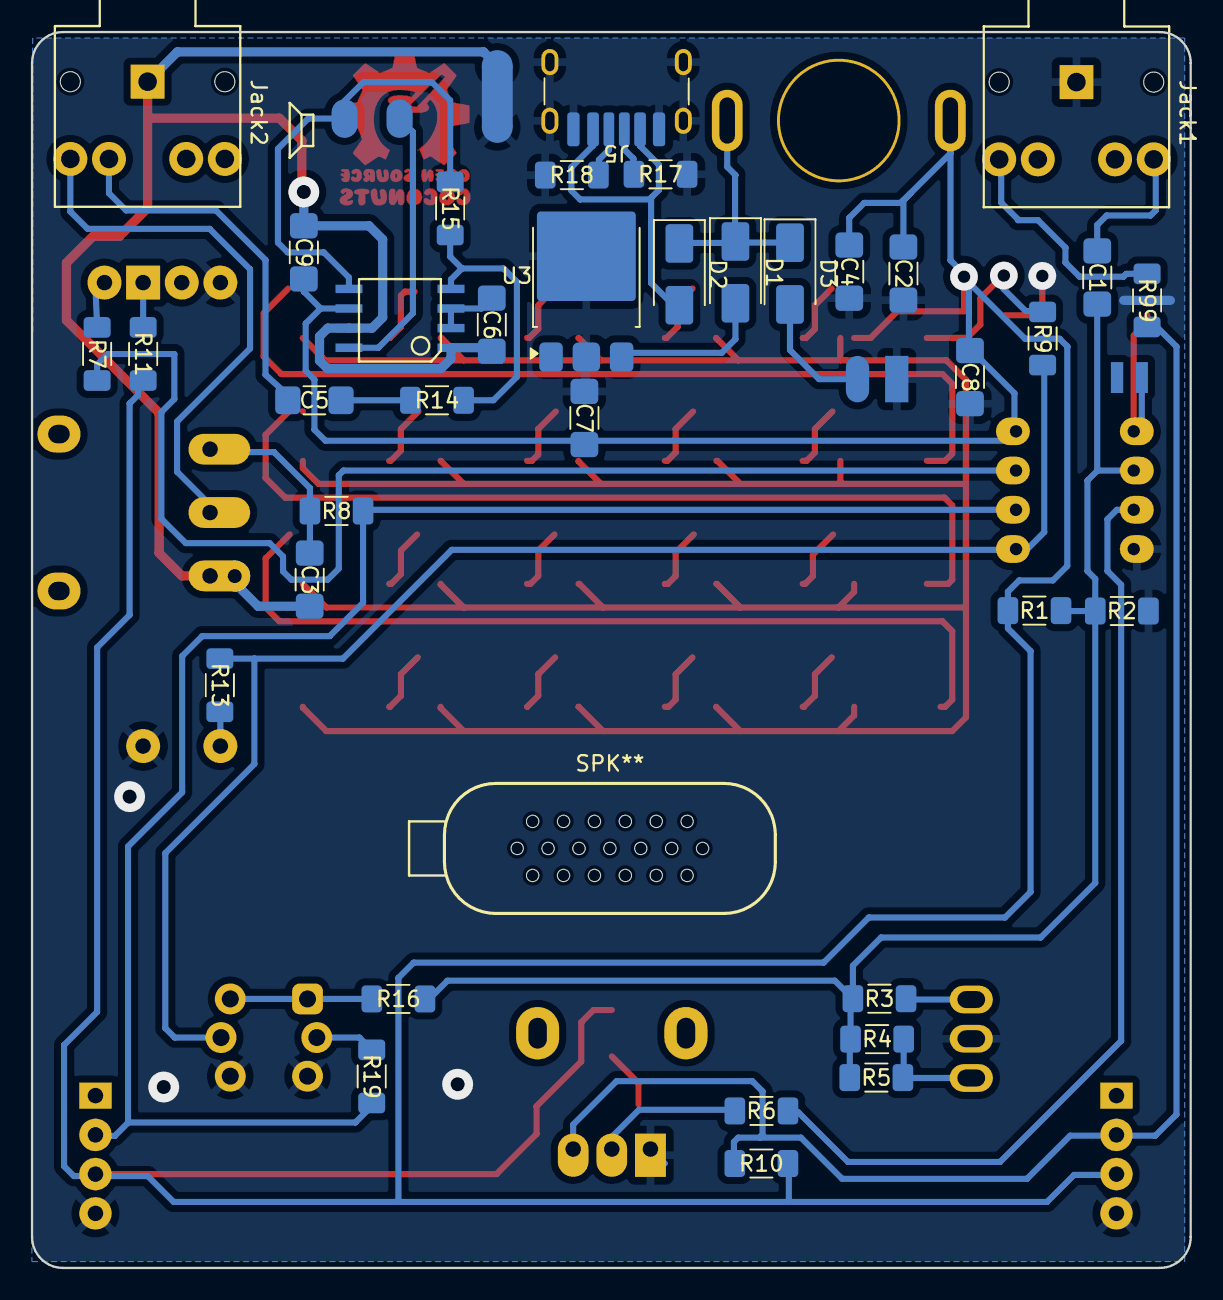
[picture p74: board ABK-20.kicad_pcb from below]

Board: 2 copper layers, 75.0 x 80.0 mm, 74 parts (42 on the bottom side), 55 nets.

Other parts of the board:
Ref**: Val**; Coconut_logo_sm
SPK**: Speaker_Micro_Loch_Honeycomb
