8BitMixtape/ABK-20/software/tools/bootloader/src/TinyAudioBoot.c

/*

  TinyAudioBoot / AudioBoot - Flashing an ATtiny85 via Audio Line-In (.WAV)

  Originally created for ATmega8/168 by C. Haberer (ChrisMicro):
    https://github.com/radioelfe/audioboot
  Reworked for ATtiny85 by Budi Prakosa (Iyok / sensorium):
    https://github.com/sensorium/TinyAudioBoot
  8Bit Mixtape & ABK-20 MS-20 Synthesizer extensions by Marc Dusseiller & Antigravity:
    https://github.com/8BitMixtape/8Bit-Vintage

  Parts of *equinox-boot.c* by Frank Meyer and Robert Meyer are used for flash SPM.

  Hardware:   Attiny85

  input pin:  should be connected to a voltage divider.
  output pin: LED for status indication of the bootloader

  The input pin is also connected by a 10nF capacitor to the PC line out

  The Atmega168 seems to have the switching voltage level at 2.2V
  The Atmega8 at 1.4V
  The switching levels of the input pins may vary a little bit from one
  MC to another.  If you to be able to adjust the voltages,
  use a 10k poti as voltage divider.


  As development platform an Arduino Diecimilla was used. Therefore you
  will find many #ifdefs for the Arduino in this code.
  If you want to optimize the bootloader further you may use an Arduino
  as development platform.


  necessary setup

  1. Project->ConfigurationOptions->Processortype
  2. Project->ConfigurationOptions->Programming Modell 'Os'
  3. Project->ConfigurationOptions->CustomOptions->LinkerOptions->see further down

  There is an article how to make an ATTINY boot loader ( German ):
  http://www.mikrocontroller.net/articles/Konzept_f%C3%BCr_einen_ATtiny-Bootloader_in_C
  ( thanks to the author of the article, very well written )


  Creating the bootloader with Atmel Studio 7
  ===========================================

  1. You have to define the bootloader sections and reset vector location

  => Toolchain/AVR_GNU_Linker/Memory Settings 
  .bootreset=0x00
  .text=0xE00 // for 1KB Bootloader
  .text=0x0C00 // for 2KB Bootloader

   explanation:
  .text=0x0E00 *2 = 0x1C00 ==> this is the start address of the boot loader with 1KB size
  .text=0x0C00 *2 = 0x1800 ==> this is the start address of the boot loader with 2KB size

  2. Disable unused sections optimization in the linker
  Be sure that in the linker parameters this is not used: -Wl, --gc-sections
  disable the following check box:
  ==>Toolchain/AVR_GNU_C Compiler/Optimization/Garbage collect unused sections


  Fuse settings for the bootloader
  ================================

  There fuses have to match certain conditions.
  Mainly SELFPROGEN has to be set, Brown-Out-Detection activated and
  CKDIV8 disabled to achieve the needed F_CPU of 8MHz

  FUSES Attiny 85 ( F_CPU 16MHz with PLL )
  ========================================
  Extended: 0xFE
  HIGH:     0xDD
  LOW:      0xE1

  ************************************************************************************

  v0.1  19.6.2008 C. -H-A-B-E-R-E-R-  Bootloader for IR-Interface
  v1.0  03.9.2011 C. -H-A-B-E-R-E-R-  Bootloader for audio signal
  v1.1  05.9.2011 C. -H-A-B-E-R-E-R-  changing pin setup, comments, and exitcounter=3
  v1.2  12.5.2012 C. -H-A-B-E-R-E-R-  Atmega8 Support added, java program has to be adapted too
  v1.3  20.5.2012 C. -H-A-B-E-R-E-R-  now interrupts of user program are working
  v1.4  05.6.2012 C. -H-A-B-E-R-E-R-  signal coding changed to differential manchester code
  v2.0  13.6.2012 C. -H-A-B-E-R-E-R-  setup for various MCs
  v3.0  30.1.2017 B. -P-r-a-k-o-s-a-  first version of Attiny85 Audio Bootloader
  v3.1  04.2.2017 C. -H-A-B-E-R-E-R-  clean reset vector added, description added, pins rerouted
  v3.2  18.7.2017 C. -P-r-a-k-o-s-a-  various refactor, added eeprom write mode, makefile for compiling using arduino ide toolchain
  v3.3  25.10.2026 M. -D-U-S-S-E-I-L-L-E-R- (dusjagr) & Antigravity
                   - Silent speaker standby: PB1 held at GND (0V) while PB0 blinks Red @ 1 Hz
                   - Alternating Green <-> Red bi-color LED visual feedback on each 64-byte page
                   - Code size optimizations (pgm_read_word, inline delay loops) down to 872 bytes
                   - Standard 1KB boundary at 0x1C00 (leaves 7,168 bytes flash for user sketches)
                   - Configurable upload timeout: 5s for Standard, 30s for Skipper
  v4.0  25.10.2026 M. -D-U-S-S-E-I-L-L-E-R- (dusjagr) & Antigravity - ABK-20 Skipper Edition
                   - Instant boot: skips bootloader in <25ms unless button SW2 is held on power-up
                   - PB3 analog resistor ladder ADC decoder (calibrated threshold ADCH <= 60 / < 1.18V)
                   - ADC-based button release wait and 20ms debounce (prevents chatter lockups)
                   - Unified single-source architecture controlled via -DUSE_SKIPPER (958 bytes)

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
ion.

  It is mandatory to keep the list of authors in this code.

*/
/*

			
           schematic for audio input
           =========================			
  	
			          VCC	
			           |	 
                      | | 10K
                      | |
                       |
			           |
 audio in >-----||-----o------->  soundprog ( digital input pin )
               100nF   |
	                   |  
                      | | 10K
                      | |
			           |
                      GND



                              Pinout ATtiny25/45/85
                              =====================
			
				
	   			     _______
                                    |   U   |
         (PCINT5/RESET/ADC0/dW) PB5-|       |- VCC
  (PCINT3/XTAL1/CLKI/OC1B/ADC3) PB3-| ATTINY|- PB2 (SCK/USCK/SCL/ADC1/T0/INT0/PCINT2) 
  (PCINT4/XTAL2/CLKO/OC1B/ADC2) PB4-|   85  |- PB1 (MISO/DO/AIN1/OC0B/OC1A/PCINT1) 
                                GND-|       |- PB0 (MOSI/DI/SDA/AIN0/OC0A/OC1A/AREF/PCINT0)	 
                                    |_______|

				  
				  
	  			  Pinout ARDUINO  
				  ==============
                                     _______				  
                                    |   U   |				  
                          reset/PB5-|       |- VCC				  
                 D3/A3          PB3-| ATTINY|- PB2       D2/A1				  
    soundprog->  D4/A2          PB4-|   85  |- PB1       D1     -> ARDUINO_LED
                                GND-|       |- PB0       D0
                                    |_______|		


				  
*/

#include <avr/io.h>
#include <avr/interrupt.h>
#include <stdlib.h>
#include <avr/boot.h>
#include <avr/pgmspace.h>
#include <avr/eeprom.h>
#include <util/delay.h>

// This value has to be adapted to the bootloader size
// If you change this, please change BOOTLOADER_ADDRESS on Makefile too

#ifndef BOOTLOADER_ADDRESS
#define BOOTLOADER_ADDRESS     0x1C00               // bootloader start address at 0x1C00 = 7168
#endif

//#define BOOTLOADER_ADDRESS     0x1800             // bootloader start address, e.g. 0x1800 = 6144, set .text to 0x0c00

#define RJMP                   (0xC000U - 1)          // opcode of RJMP minus offset 1
#define RESET_SECTION          __attribute__((section(".bootreset"))) __attribute__((used))

// this variable seems to be unused
// but in fact it is written into the flash section
// you could find it in the *.hex file
uint16_t resetVector RESET_SECTION = RJMP + BOOTLOADER_ADDRESS / 2;

#ifdef DEBUGON

	#define DEBUGPIN       ( 1<<PB2 ) 
	#define INITDEBUGPIN   { DDRB  |=  DEBUGPIN; }

	#define DEBUGPINON     { PORTB |=  DEBUGPIN;}
	#define DEBUGPINOFF    { PORTB &= ~DEBUGPIN;}
	#define TOGGLEDEBUGPIN { PORTB ^=  DEBUGPIN;}
	
#else

	#define DEBUGPIN       
	#define INITDEBUGPIN   

	#define DEBUGPINON     
	#define DEBUGPINOFF    
	#define TOGGLEDEBUGPIN 
	
#endif
	
	
#define USELED
#ifdef USELED

#define INITLED do { \
    DDRB |= (1 << PB0) | (1 << PB1); \
    PORTB &= ~((1 << PB0) | (1 << PB1)); \
} while(0)

#define LED_GREEN()    do { PORTB = (PORTB & ~(1 << PB0)) | (1 << PB1); } while(0)
#define LED_RED()      do { PORTB = (PORTB & ~(1 << PB1)) | (1 << PB0); } while(0)
#define LED_OFF()      do { PORTB &= ~((1 << PB0) | (1 << PB1)); } while(0)
#define TOGGLE_GREEN() do { PORTB &= ~(1 << PB0); PORTB ^= (1 << PB1); } while(0)
#define TOGGLE_RED()   do { PORTB &= ~(1 << PB1); PORTB ^= (1 << PB0); } while(0)

#define LEDON      LED_RED()
#define LEDOFF     LED_OFF()
#define TOGGLELED  TOGGLE_RED()

#else

#define LEDPORT 
#define INITLED 
#define LEDON 
#define LEDOFF 
#define TOGGLELED 

#endif

#define INPUTAUDIOPIN (1<<PB3) //
#define PINVALUE (PINB&INPUTAUDIOPIN)
#define INITAUDIOPORT {DDRB&=~INPUTAUDIOPIN;} // audio pin is input

#define PINLOW (PINVALUE==0)
#define PINHIGH (!PINLOW)

#define WAITBLINKTIME 10000
#ifdef USE_SKIPPER
#define BOOT_TIMEOUT  60 // 60 toggles @ 0.5s = 30 seconds window for skipper upload
#else
#define BOOT_TIMEOUT  10 // 10 toggles @ 0.5s = 5 seconds window for standard bootloader
#endif

#define true (1==1)
#define false !true

//***************************************************************************************
// main loop
//***************************************************************************************

#define TIMER TCNT0 // we use timer1 for measuring time

// frame format definition: indices
#define COMMAND         0
#define PAGEINDEXLOW    1  // page address lower part
#define PAGEINDEXHIGH   2  // page address higher part
#define LENGTHLOW       3
#define LENGTHHIGH      4
#define CRCLOW          5  // checksum lower part 
#define CRCHIGH         6  // checksum higher part 
#define DATAPAGESTART   7  // start of data
#define PAGESIZE        SPM_PAGESIZE
#define FRAMESIZE       (PAGESIZE+DATAPAGESTART) // size of the data block to be received

// bootloader commands
#define NOCOMMAND       0
#define TESTCOMMAND     1
#define PROGCOMMAND     2
#define RUNCOMMAND      3
#define EEPROMCOMMAND   4
#define EXITCOMMAND     5

uint8_t FrameData[ FRAMESIZE ];

#define FLASH_RESET_ADDR        0x0000                 // address of reset vector (in bytes)
#define BOOTLOADER_STARTADDRESS BOOTLOADER_ADDRESS    // start address:
#define BOOTLOADER_ENDADDRESS   0x2000                // end address:   0x2000 = 8192
                                                      // this is the size of the Attiny85 flash in bytes
													  
#define LAST_PAGE (BOOTLOADER_STARTADDRESS - SPM_PAGESIZE) / SPM_PAGESIZE

#include <avr/boot.h>
#ifndef RWWSRE                                        // bug in AVR libc:
#define RWWSRE CTPB                                   // RWWSRE is not defined on ATTinys, use CTBP instead
#endif

void (*start_appl_main) (void);

#define BOOTLOADER_FUNC_ADDRESS (BOOTLOADER_STARTADDRESS - sizeof (start_appl_main))

#ifndef sei
#define sei() asm volatile("sei")
#endif
#ifndef cli
#define cli() asm volatile("cli")
#endif
#ifndef nop
#define nop() asm volatile("nop")
#endif
#ifndef wdr
#define wdr() asm volatile("wdr")
#endif

//AVR ATtiny85 Programming: EEPROM Reading and Writing - YouTube
//https://www.youtube.com/watch?v=DO-D6YmRpJk

#if 0
void eeprom_write(unsigned short address, unsigned char data)
{
   while(EECR & (1<<EEPE));

   EECR = (0<<EEPM1) | (0<<EEPM0);

   if (address < 512)
   {
      EEAR = address;
   }else{
      EEAR = 511;
   }

   EEDR = data;

   EECR |= (1<<EEMPE);
   EECR |= (1<<EEPE);  
}
#endif

//***************************************************************************************
// receiveFrame()
//
// This routine receives a differential manchester coded signal at the input pin.
// The routine waits for a toggling voltage level.
// It automatically detects the transmission speed.
//
// output:    uint8_t flag:     true: checksum OK
//            uint8_t FramData: global data buffer
//
//***************************************************************************************
uint8_t receiveFrame()
{
  //uint16_t store[16];

  uint16_t counter = 0;
  uint16_t time = 0;
  uint16_t delayTime;
  uint8_t p, t;
  uint8_t k = 8;
  uint8_t dataPointer = 0;
  uint16_t n;

  //*** synchronisation and bit rate estimation **************************
  time = 0;
  // wait for edge
  p = PINVALUE;
  while (p == PINVALUE);

  p = PINVALUE;

  TIMER = 0; // reset timer
  for (n = 0; n < 16; n++)
  {
    // wait for edge
    while (p == PINVALUE);
    t = TIMER;
    TIMER = 0; // reset timer
    p = PINVALUE;

    //store[counter++] = t;

    if (n >= 8)time += t; // time accumulator for mean period calculation only the last 8 times are used
  }

  delayTime = time * 3 / 4 / 8;
  // delay 3/4 bit
  while (TIMER < delayTime);

  //p=1;

  //****************** wait for start bit ***************************
  while (p == PINVALUE) // while not startbit ( no change of pinValue means 0 bit )
  {
    // wait for edge
    while (p == PINVALUE);
    p = PINVALUE;
    TIMER = 0;

    // delay 3/4 bit
    while (TIMER < delayTime);
    TIMER = 0;

    counter++;
  }
  p = PINVALUE;
  
  //****************************************************************
  //receive data bits
  k = 8;
  for (n = 0; n < (FRAMESIZE * 8); n++)
  {
    // wait for edge
    while (p == PINVALUE);
    TIMER = 0;
    p = PINVALUE;

    // delay 3/4 bit
    while (TIMER < delayTime);

    t = PINVALUE;
	  

    counter++;

    FrameData[dataPointer] = FrameData[dataPointer] << 1;
    if (p != t) FrameData[dataPointer] |= 1;
    p = t;
    k--;
    if (k == 0) {
      dataPointer++;
      k = 8;
    };
  }
  //uint16_t crc = (uint16_t)FrameData[CRCLOW] + FrameData[CRCHIGH] * 256;
  
  
  return true;
}

/*-----------------------------------------------------------------------------------------------------------------------
   Flash: fill page word by word
  -----------------------------------------------------------------------------------------------------------------------
*/
#define boot_program_page_fill(byteaddr, word)      \
  {                                                 \
    uint8_t sreg;                                   \
    sreg = SREG;                                    \
    cli ();                                         \
    boot_page_fill ((uint32_t) (byteaddr), word);   \
    SREG = sreg;                                    \
  }

/*-----------------------------------------------------------------------------------------------------------------------
   Flash: erase and write page
  -----------------------------------------------------------------------------------------------------------------------
*/
#define boot_program_page_erase_write(pageaddr)     \
  {                                                 \
    uint8_t sreg;                                   \
    eeprom_busy_wait ();                            \
    sreg = SREG;                                    \
    cli ();                                         \
    boot_page_erase ((uint32_t) (pageaddr));        \
    boot_spm_busy_wait ();                          \
    boot_page_write ((uint32_t) (pageaddr));        \
    boot_spm_busy_wait ();                          \
    boot_rww_enable ();                             \
    SREG = sreg;                                    \
  }


/*-----------------------------------------------------------------------------------------------------------------------
   write a block into flash
  -----------------------------------------------------------------------------------------------------------------------
*/
static void
pgm_write_block (uint16_t flash_addr, uint16_t * block, size_t size)
{
  uint16_t        start_addr;
  uint16_t        addr;
  uint16_t        w;
  uint8_t         idx = 0;

  start_addr = (flash_addr / SPM_PAGESIZE) * SPM_PAGESIZE;        // round down (granularity is SPM_PAGESIZE)

  for (idx = 0; idx < SPM_PAGESIZE / 2; idx++)
  {
    addr = start_addr + 2 * idx;

    if (addr >= flash_addr && size > 0)
    {
      w = *block++;
      size -= sizeof (uint16_t);
    }
    else
    {
      w = pgm_read_word (addr);
    }

    boot_program_page_fill (addr, w);
  }

  boot_program_page_erase_write(start_addr);                      // erase and write the page
}


//***************************************************************************************
//  void boot_program_page (uint32_t page, uint8_t *buf)
//
//  Erase and flash one page.
//
//  input:     page address and data to be programmed
//
//***************************************************************************************
void boot_program_page (uint32_t page, uint8_t *buf)
{
  uint16_t i;
  cli(); // disable interrupts

  boot_page_erase(page);
  boot_spm_busy_wait ();      // Wait until the memory is erased.

  for (i = 0; i < SPM_PAGESIZE; i += 2)
  {
    //read received data
    uint16_t w = *buf++; //low section
    w += (*buf++) << 8; //high section
    //combine low and high to get 16 bit

    //first page and first index is vector table... ( page 0 and index 0 )
    if (page == 0 && i == 0)
    {
      
      //1.save jump to application vector for later patching
      void* appl = (void *)(w - RJMP);
      start_appl_main =  ((void (*)(void)) appl);

      //2.replace w with jump vector to bootloader
      w = 0xC000 + (BOOTLOADER_ADDRESS / 2) - 1;
    }
    // else if (page == LAST_PAGE && i == 60)
    // {
      //3.retrieve saved reset vector
      // w = saved_reset_vector;
    // }

    boot_page_fill (page + i, w);
    boot_spm_busy_wait();       // Wait until the memory is written.
  }

  boot_page_write (page);     // Store buffer in flash page.
  boot_spm_busy_wait();       // Wait until the memory is written.
}

void resetRegister()
{
    DDRB = 0;
    cli();
    TCCR0B = 0; // turn off timer1
}

void exitBootloader()
{  
  start_appl_main = (void (*)(void)) pgm_read_word(BOOTLOADER_FUNC_ADDRESS);

  if (start_appl_main && (uint16_t)start_appl_main != 0xFFFF)
  {
    resetRegister();
    (*start_appl_main) ();
  }
}

void runProgramm(void)
{
  // reintialize registers to default
  resetRegister();

  pgm_write_block (BOOTLOADER_FUNC_ADDRESS, (uint16_t *) &start_appl_main, sizeof (start_appl_main));

  start_appl_main();
}

#ifdef USE_SKIPPER
// Skipper button check on PB3 analog ladder
static inline void checkBootloaderSkip(void)
{
  // Power settling delay (~20ms @ 16MHz) for VCC rail and 100nF C1 capacitor
  _delay_ms(20);

  // ADC3 on PB3, VCC reference, Left-adjust result (8-bit reading in ADCH)
  ADMUX = (1 << ADLAR) | (1 << MUX1) | (1 << MUX0);
  // Enable ADC, start first warm-up conversion, prescaler 64 (~250kHz @ 16MHz)
  ADCSRA = (1 << ADEN) | (1 << ADSC) | (1 << ADPS2) | (1 << ADPS1);
  while (ADCSRA & (1 << ADSC)); // wait for first conversion
  ADCSRA |= (1 << ADSC);        // start 2nd conversion
  while (ADCSRA & (1 << ADSC)); // wait for 2nd conversion
  uint8_t val = ADCH;

  // Calibrated threshold: ~1.18 V (ADCH = 60)
  // SW2 pressed: 0.99 V -> ADCH ~51 (solo), 0.82 V -> ADCH ~42, 0.70 V -> ADCH ~36
  // Toggle 2 (UP) alone: 1.29 V -> ADCH ~66
  // Toggle 1 (DOWN) alone: 1.72 V -> ADCH ~88
  // Idle (no button): 2.63 V -> ADCH ~134
  //
  // If val > 60: Button SW2 is NOT pressed -> skip bootloader and immediately run user sketch!
  if (val > 60) {
    ADCSRA = 0; // disable ADC
    exitBootloader();
  }

  // Visual confirmation: SW2 hold detected, turn RED LED on while waiting for release
  LED_RED();

  // Wait until user releases SW2 using ADC (voltage rises above 1.18V)
  do {
    ADCSRA |= (1 << ADSC);
    while (ADCSRA & (1 << ADSC));
  } while (ADCH <= 60);

  // Button released: debounce delay (~20ms @ 16MHz) to let PB3 ladder settle cleanly
  _delay_ms(20);

  ADCSRA = 0; // disable ADC to save power & restore PB3 for audio
}
#endif

//***************************************************************************************
// main loop
//***************************************************************************************
static inline void a_main()
{
  uint8_t p;
  uint16_t time = WAITBLINKTIME;
  uint8_t timeout = BOOT_TIMEOUT;

  p = PINVALUE;

  //*************** wait for toggling input pin or timeout ******************************
  uint8_t exitcounter = 3;
  while (1)
  {

    if (TIMER > 100) // timedelay ==> frequency @16MHz= 16MHz/8/100=20kHz
    {
      TIMER = 0;
      time--;
      if (time == 0)
      {
        TOGGLELED;

        time = WAITBLINKTIME;
        timeout--;
        if (timeout == 0)
        {
          LEDOFF; // timeout,
          // leave bootloader and run program
          exitBootloader();
        }
      }
    }
    if (p != PINVALUE)
    {
      p = PINVALUE;
      exitcounter--;
    }
    if (exitcounter == 0) break; // signal received, leave this loop and go on
  }
  //*************** start command interpreter *************************************
  LEDON;
  while (1)
  {
    if (!receiveFrame())
    {
      //*****  if data transfer error: blink fast in RED, press reset to restart *******************

      while (1)
      {
        if (TIMER > 100) // timerstop ==> frequency @16MHz= 16MHz/8/100=20kHz
        {
          TIMER = 0;
          time--;
          if (time == 0)
          {
            TOGGLE_RED();
            time = 1000;
          }
        }
      }
    }
    else // succeed
    {
      switch (FrameData[COMMAND])
      {

        case PROGCOMMAND:
        {
            uint16_t pageNumber = (((uint16_t)FrameData[PAGEINDEXHIGH]) << 8) + FrameData[PAGEINDEXLOW];
			      uint16_t address=SPM_PAGESIZE * pageNumber;
			
            if( address < BOOTLOADER_ADDRESS) // prevent bootloader form self killing
        		{
        			boot_program_page (address, FrameData + DATAPAGESTART);  // erase and program page
        			
              // While programming: always alternate Green and Red on every page!
              if (pageNumber & 1) {
                LED_RED();
              } else {
                LED_GREEN();
              }
        		}
        }
        break;

        case RUNCOMMAND:
        {
            LED_OFF();
            // after programming leave bootloader and run program
            runProgramm();
        }
        break;

        // case EXITCOMMAND:
        // {
        //     // after programming leave bootloader and run program
        //     exitBootloader();
        // }
        // break;

#if 0
        case EEPROMCOMMAND:
        {
            uint8_t pageNumber = FrameData[PAGEINDEXLOW];
            uint8_t data_length = FrameData[LENGTHLOW];
            uint8_t address = SPM_PAGESIZE * pageNumber;

            uint8_t *buf = FrameData + DATAPAGESTART;
            
            for (uint8_t i = 0; i < data_length; i++)
            {
              //write received data to EEPROM
              uint8_t w = *buf++;
              eeprom_write(address + i, w);
            }

            //Leave bootloader after eeprom signal received
            //todo: wait until all data sent > spm pagesize (64)
            //fix this!!!!
            LEDOFF;
            exitBootloader();

        }
        break;
#endif
      }
      FrameData[COMMAND] = NOCOMMAND; // delete command
    }
  }
}

int main()
{
  INITDEBUGPIN
  INITLED;
  INITAUDIOPORT;

#ifdef USE_SKIPPER
  checkBootloaderSkip();
#endif

  // Timer 2 normal mode, clk/8, count up from 0 to 255
  // ==> frequency @16MHz= 16MHz/8/256=7812.5Hz
  TCCR0B = _BV(CS01);

  a_main(); // start the main function
}
