8BitMixtape/ABK-20/(commit log)

2026-10-16 Initial repository scaffolding and KiCad 9 project setup
2026-10-16 Import 8BitMixtape_reworked base design, libraries, and footprints into ABK-20
2026-10-16 Fix KiCad 5 to KiCad 9 symbol migration: upgrade cache symbols to kicad_sym and remap components
2026-10-16 Update sym-lib-table with ABK-20-rescue kicad_sym mapping
2026-10-16 Remove obsolete legacy library references (power.lib, device.lib, etc.)
2026-10-16 Restore clean unprefixed KiCad 4 schematic ready for Remap Symbols dialog
2026-10-16 Successfully migrated to native KiCad 9 schematic (ABK-20.kicad_sch)
2026-10-16 Add remaining NeoPixels: complete 5x4 matrix (20 LEDs) in raster-scan daisy chain
2026-10-16 fixed the schematic and in v9 now
2026-10-16 Add multi-unit Potentiometer_Slide_LED symbol (Unit A: Pot, Unit B: LED)
2026-10-16 Add Bourns PTL20 slide potentiometer with LED footprint
2026-10-16 Move 5x4 NeoPixel matrix into hierarchical sheet (LED_Matrix.kicad_sch)
2026-10-16 Convert top sheet to A4 paper and fit layout to frame
2026-10-16 Update README with prototype photo, schematic renders, and hardware documentation
2026-10-16 Correct potentiometer and push button documentation in README and hardware notes
2026-10-16 Optimize PAM8002 audio amplifier circuit: set R14=22k for unity gain, C5=1uF, and add C8 100nF decoupling
2026-10-16 Implement diode OR-ing power architecture with Schottky isolation and master latching switch
2026-10-16 Replace USB connector with 6-pin USB-C power-only receptacle symbol (J5)
2026-10-16 Add 5.1k pull-down resistors (R17, R18) on USB-C CC1 and CC2 for USB-PD detection
2026-10-16 Allocate footprints for all components: RV1 (PTL20), SW3 (SPDT), R17/R18 (1206), U3 (TO-252)
2026-10-16 feat(pcb): layout 90x90mm desktop wedge panel matching prototype
2026-10-16 feat(pcb): autoroute 578 track segments and 37 vias with filled ground plane
2026-10-17 Fix Bourns PTL20 slide pot footprint: correct Pin B (+LED) position to y=+3.75mm (5.0mm pitch to Pin 3)
2026-10-17 Align right pins of Bourns PTL20 slide pot to lower part: Pad 3 at y=+1.25mm, Pad 5 at y=-3.75mm
2026-10-17 Revert "Align right pins of Bourns PTL20 slide pot to lower part: Pad 3 at y=+1.25mm, Pad 5 at y=-3.75mm"
    This reverts commit 92f39985ae9dbf8340b4526a1e2fbbaba511cbc4.
2026-10-17 feat(footprint): update slide pot to Bourns PTL30 (30mm travel, +-20mm column pitch)
2026-10-17 feat(footprint): maintain distinct PTL20 (+-15mm) and PTL30 (+-20mm) slide pot footprints
2026-10-17 fix(3d-models): update all 3D model paths to KiCad 9 and bundle project 3D models
2026-10-17 fix(library): remove duplicate legacy models from footprints
2026-10-17 fix(pcb): update all 67 component 3D models to valid paths in current board layout
2026-10-17 fix(pcb): flip components to F.Cu and correct horizontal audio jack 3D orientation
2026-10-17 feat(3d-models): create accurate 12x8mm flashlight power switch model (KAN-28)
2026-10-17 feat(3d-models): add miniature SPDT toggle switch with red rubber cap for SW3
2026-10-17 fix(3d-models): flip flashlight switch legs upward through PCB and retain SW3 toggle
2026-10-17 feat(3d-models): update SW2 to standard low-profile SMD tact switch (Omron B3FS-100xP)
2026-10-17 feat(3d-models): update SW3 to sub-miniature SPDT toggle switch with red cap
2026-10-17 feat(3d-models): create and assign Bourns PTL20/PTL30 slide pot models with LED lever
2026-10-17 fix(pcb, 3d-models): adjust Bourns PTL lever height to 10mm and shift side pins by 2.5mm
2026-10-17 hardware(3d): reduce potentiometer shaft height from 30mm to 21mm
2026-10-17 hardware(3d): change slide potentiometer LED lens color to illuminated orange
2026-10-17 hardware(3d): add 16mm thumbwheel potentiometer (B103) 3D model for POT3-Vol1
2026-10-17 fix(pcb, footprints): shift Bourns slide pot right side pads +2.5mm in Y to match physical part
2026-10-17 feat(hardware): add Highly KS01-BL-13 illuminated keypad button footprint and 3D model for SW2
2026-10-17 Add 2-unit SW_Push_LED symbol for KS01-BL-13 with switch (Unit A) and bi-color LED (Unit B)
2026-10-17 style(schematic): rearrange SW2 push button and LED into grouped block
2026-10-17 refactor(pcb): reset pcb layout, clear all tracks/vias/zones and arrange footprints outside board
2026-10-17 feat(pcb): place 5x4 NeoPixel array with BlinkeShit pitch and single-sided F.Cu snake tracks
2026-10-17 chore(pcb): rearrange components around board for layout placement
2026-10-17 docs: add 3D PCB layout render and section to README
2026-10-17 feat(pcb): set board outline to 75x80 mm on Edge.Cuts for compact desktop design
2026-10-17 docs(schematic): re-export multi-page PDF and PNGs reflecting latest schematic updates
2026-10-18 feat(pcb): finalize 75x80 component placement, self-contained 3D models, and variant showcase
    - Place all core components on 75x80 mm board outline: 5x4 NeoPixel matrix, ATtiny85 DIP socket, Bourns slide pot, thumbwheel pot, illuminated RV09 pot, toggle switch, jacks, buttons, and side headers
    - Create self-contained local 3D VRML library in hardware/3d_models/ with all project models bundled
    - Add ABK-20_showcase_variants.kicad_pcb as standalone comparison showroom
    - Fix pin numbering on 7805 voltage regulator (U3) and potentiometer mounting tabs (MP/L)
    - Clean up jumper footprints and synchronize schematic assignments
2026-10-18 docs(readme): update PCB layout section with 75x80 mm design and 3D render
2026-10-18 docs: re-export latest schematics and add 3D hardware variants showroom to README
2026-10-18 Sync schematic and PCB: restore BT1/BT2/J3 and fix Jack1/Jack2 pin 6
2026-10-20 feat(hardware): complete 75x80 mm PCB routing, interactive BOM, 3D models and gerbers
2026-10-20 chore(cleanup): remove obsolete KiCad 5 migration artifacts and add rescue-backup to .gitignore
2026-10-20 chore(docs): organize datasheets and images, remove obsolete schematic/pcb exports
2026-10-20 moved bom
2026-10-20 docs: use relative markdown links for showroom and schematic
2026-10-20 docs: update directory tree with production bom and mask structure
2026-10-20 feat: add CERN-OHL-S-2.0 license, update README badge, and sync schematic properties
2026-10-20 feat(3d): add high-fidelity 3D model for Blossom 412-SMT AAA battery holder with bronze pins
2026-10-20 feat(3d): refine battery holder to match official CAD profile (chamfered posts, cylindrical trough, angled leaf spring)
2026-10-21 docs(hardware): document headphone jack automatic amp shutdown circuit for v0.3
2026-10-21 docs(hardware): record Star Grounding requirements for v0.3 to eliminate NeoPixel ground bounce
2026-10-24 hardware(schematic): introduce GNDA star grounding net and NT1 Net-Tie
2026-10-24 hardware: implement GNDA star grounding, NT1 net tie, and SW2 bi-directional LED circuit for Rev 0.3
2026-10-31 hw(rev-0.3): update PCB layout, 3D component models, fabrication masks, and enclosure systems
2026-10-31 feat(case): set diffuser_grid as default in SCAD and update prototype top jack preset to perfect proto
2026-10-31 feat(hardware): add micro-speaker acoustic footprints and enclosure acoustic plan
2026-10-31 feat(enclosure): add acoustic waveguide chimney, classic grill styles, and support-free bass kit
    - Integrate downward acoustic waveguide chimney into ABK-20_case_3dprint and ABK-20_frontplate_3dprint
    - Add 8 selectable classic vintage speaker grill styles (Braun T3 horizontal slits, soundwave EQ, dot matrix, 80s chevrons, radial starburst, etc.)
    - Fix 2D slot offset vanishing bug to ensure crisp cutouts across all grill styles
    - Add ABK-20_speaker_acoustic_kit.scad with Standard (2.4 cm³), XL (5.1 cm³), and MAX (6.3 cm³) back cups
    - Implement continuous flat PCB support keel for 100% support-free FDM printing
    - Resolve legacy -0.44mm SVG viewBox offset with panel_alignment='symmetric' for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
2026-10-31 fix(frontplate): extend acoustic chimney to PCB level for airtight acoustic seal
    - Extend chimney waveguide down to z_pcb_top + chimney_pcb_clearance (-7.15mm)
    instead of stopping at -baffle_depth (-6.5mm)
    - Eliminate lateral 0.8mm air gap to prevent acoustic pressure bleed beneath panel
    - Add parametric chimney_pcb_clearance parameter (default 0.15mm)
    - Update ABK-20_frontplate_3dprint.stl and underside render
2026-10-31 fix(case): calibrate acoustic chimney clearance, update presets/STL, and clean test files
    - Align acoustic waveguide chimney distance in ABK-20_case_3dprint.scad (slider range [0.00:0.05:2.00])
    - Synchronize acoustic parameters (chimney, grill style) across all presets in ABK-20_case_3dprint.json
    - Recompile binary production STL ABK-20_case_3dprint.stl with acoustic chimney and Braun slits
    - Remove intermediate test screenshots, temporary showcase SCAD, and legacy acoustic kit 3MF
    - Preserve KiCad PCB footprint arrangement
2026-10-31 feat(hardware): finalize Rev 0.3 DIY etching mask pipeline, rerouted PCB, and custom mask presets
2026-11-01 wriring help for DIY pcb
2026-11-02 Refactor repo structure: dedicate web/ to GitHub Pages player, organize docs/ by domain, add A4 drill handout
2026-11-02 feat(hardware): introduce side-by-side ABK-20_DIY.kicad_pcb edition decoupled from factory board
2026-11-02 feat(hardware): provide complete self-contained ABK-20_DIY KiCad project and schematic
2026-11-02 feat(hardware): update slider footprint, add DIY ground vias, and deploy interactive BOM
    - Calibrate Bourns PTL20 slide potentiometer drill holes to 1.0mm
    - Add wire bridge vias for non-PTH DIY etching ground continuity
    - Update A4 drill handout and generator script (88 holes across 7 vias)
    - Export and deploy Interactive HTML BOM to web/ibom.html for GitHub Pages
    - Recover 3D-printable solder paste stencil files in production/stenchill/
    - Add reusable DIY non-PTH copper continuity audit script
    - Update .gitignore for KiCad local project settings (*.kicad_prl)
2026-11-02 docs(hardware): document DIY physical assembly dual-side solder checklist and update guide
2026-11-02 final fixes for GND DIY board vias
2026-11-02 imrpvied laser cut file. for inserts into the wood, instead of thru
