8BitMixtape/ABK-20/(notices)

Notices in the files:
hardware/3d_models/SW_SPST_Omron_B3FS-100xP.step:
Copyright (C) 2025, KiCAD
This work is licensed under the
[Creative Commons CC-BY-SA 4.0 License](https://creativecommons.org/licenses/by-sa/4.0/legalcode),
with the following exception:
project files under this or any other license agreement. However, if you wish to distribute
software/tools/bootloader/src/TinyAudioBoot.c:
This program is free software; you can redistribute it and/or modify
it under the terms of the GNU General Public License as published by
the Free Software Foundation; either version 2 of the License, or
(at your option) any later version.
